2BRobots/skykontrolVending/README.md

# skykontrolVending
This repository contains all the hardware and software used by 2BRobots to create and support IoT vending machines.
