2BRobots/skykontrolVending/Cloud/skykontrol/images/2brobots.png

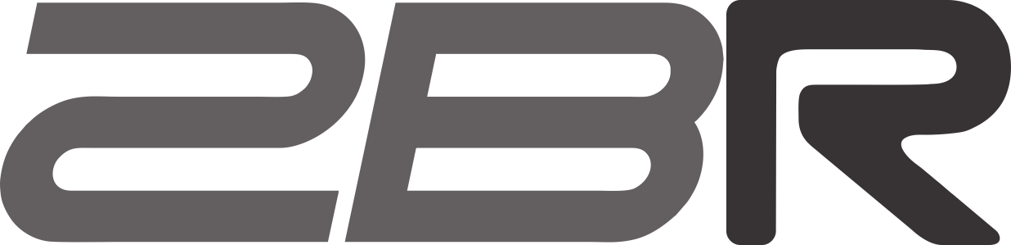
Cloud/skykontrol/images/2brobots.png
