2BRobots/skykontrolVending/Cloud/skykontrol/images/ecofill.png

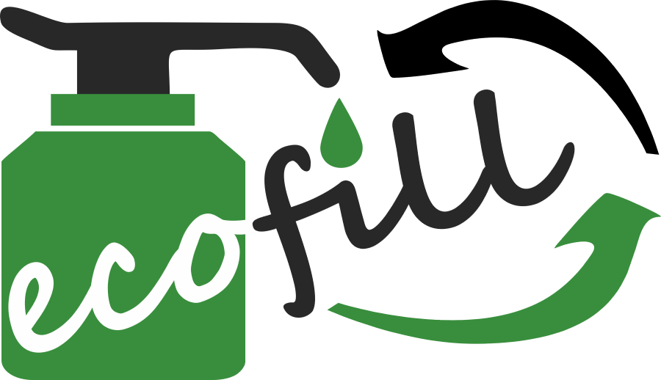
Cloud/skykontrol/images/ecofill.png
