2BRobots/skykontrolVending/Hardware/BasicDisplay/bottom.png

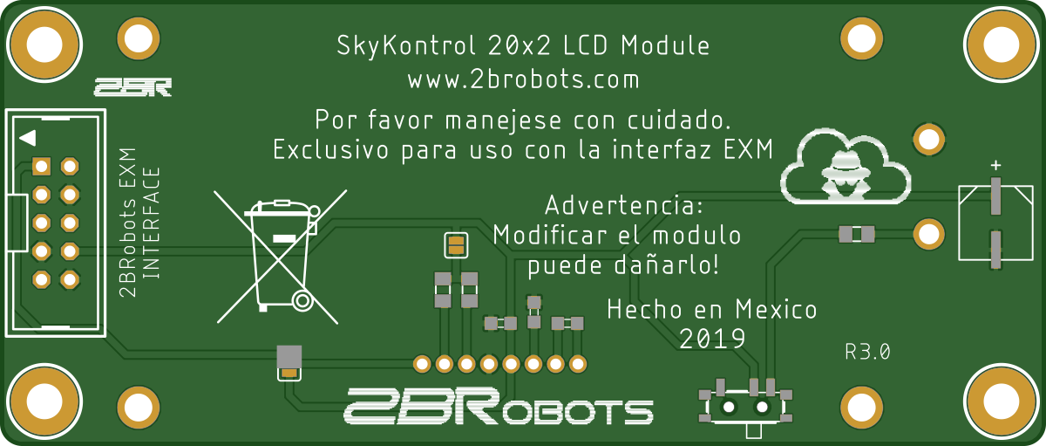
Hardware/BasicDisplay/bottom.png
