2BRobots/skykontrolVending/Hardware/BasicDisplay/schematic.png

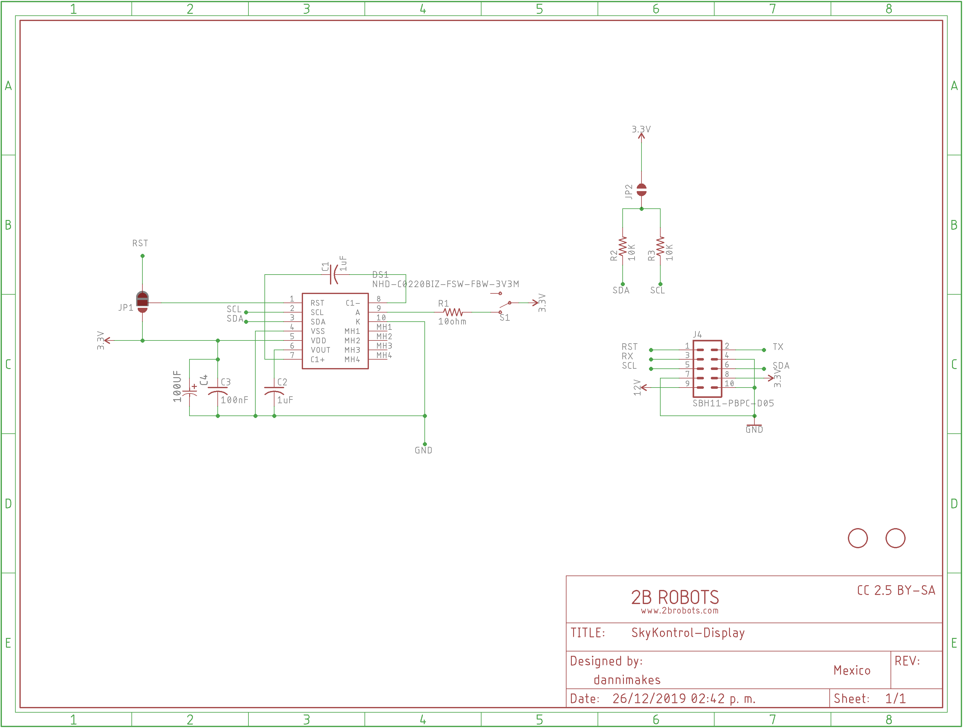
Hardware/BasicDisplay/schematic.png
