2BRobots/skykontrolVending/Hardware/BasicDisplay/top.png

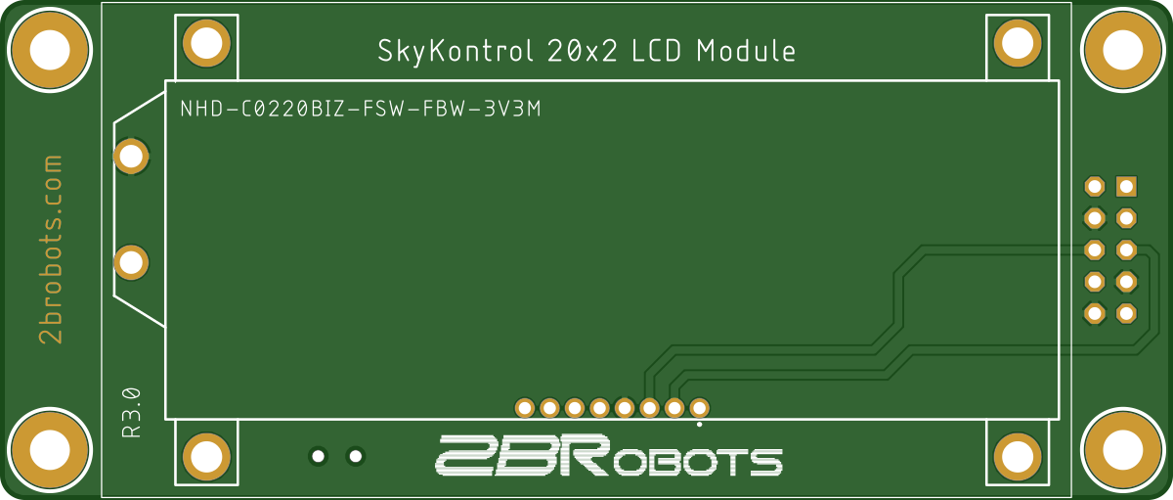
Hardware/BasicDisplay/top.png
