2BRobots/skykontrolVending/Hardware/Datalogger/bottom.png

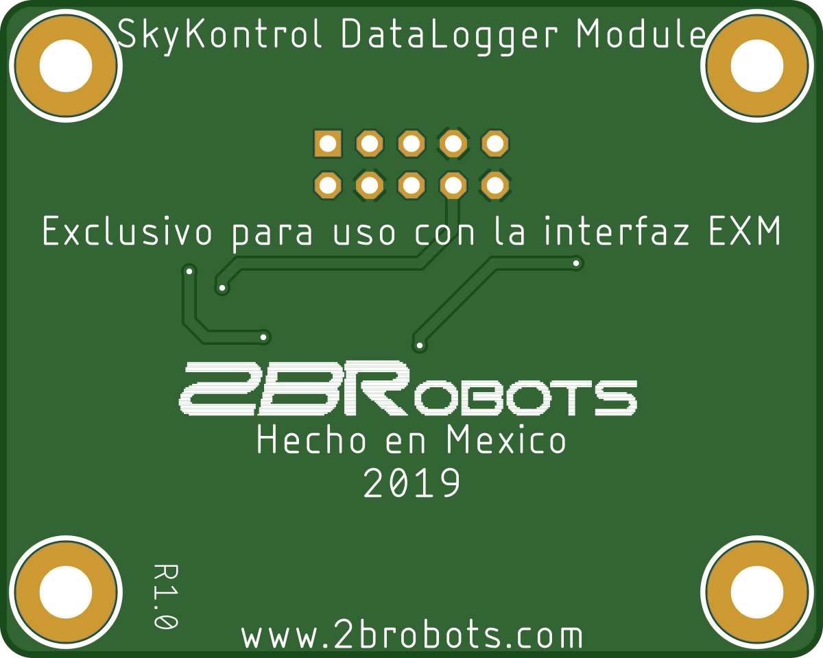
Hardware/Datalogger/bottom.png
