2BRobots/skykontrolVending/Hardware/Datalogger/schematic.png

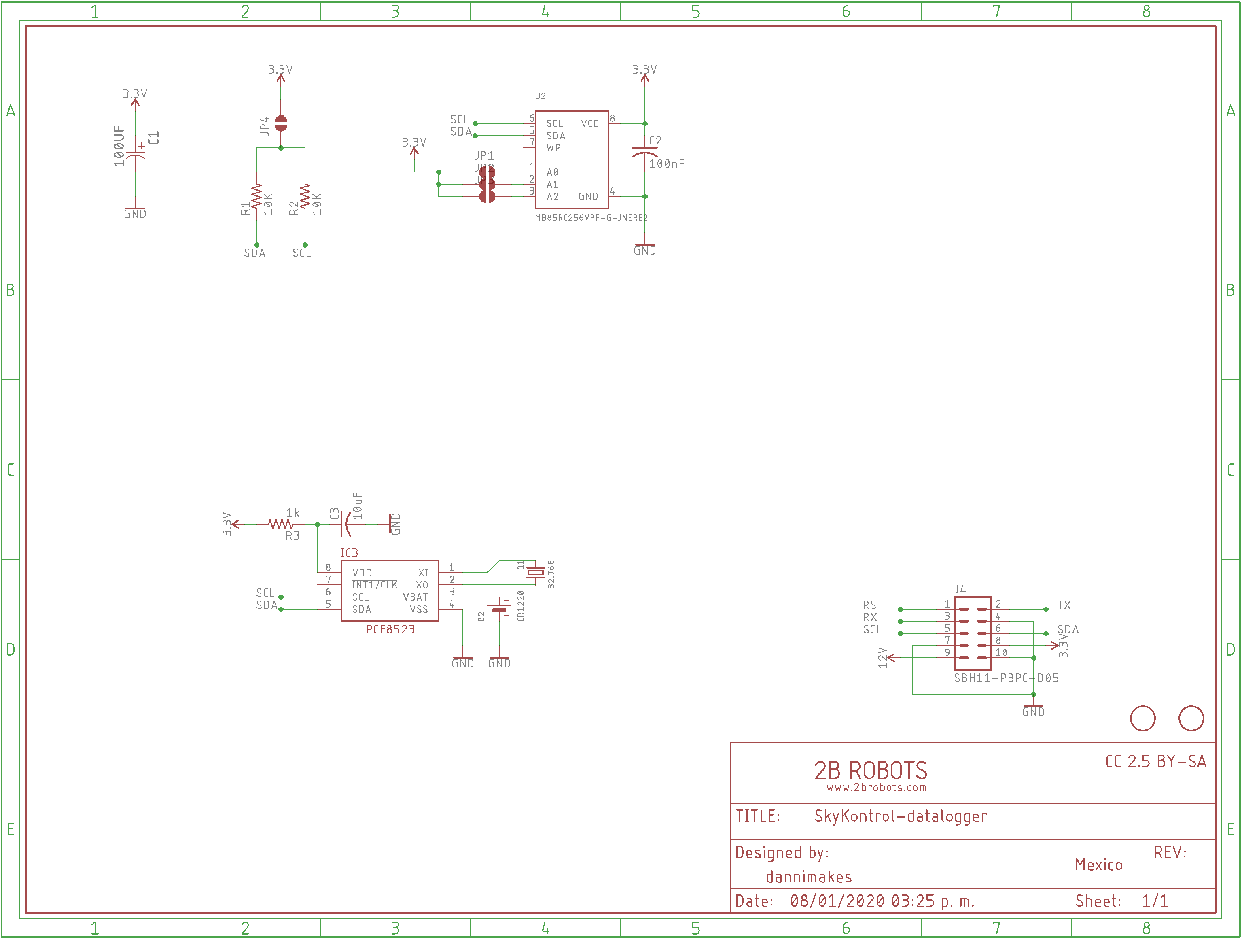
Hardware/Datalogger/schematic.png
