2BRobots/skykontrolVending/Hardware/Datalogger/top.png

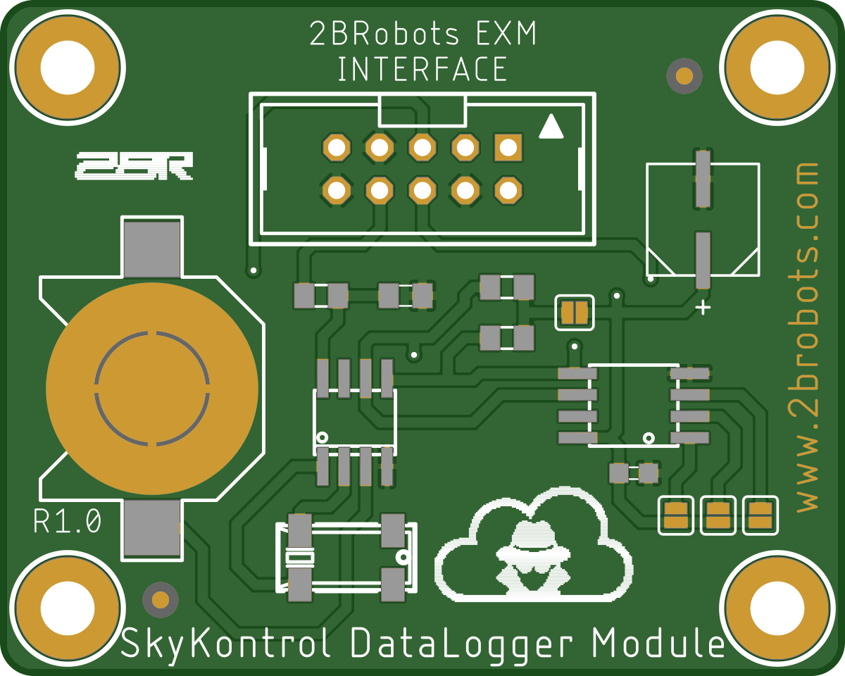
Hardware/Datalogger/top.png
