2BRobots/skykontrolVending/Hardware/IotController/bottom.png

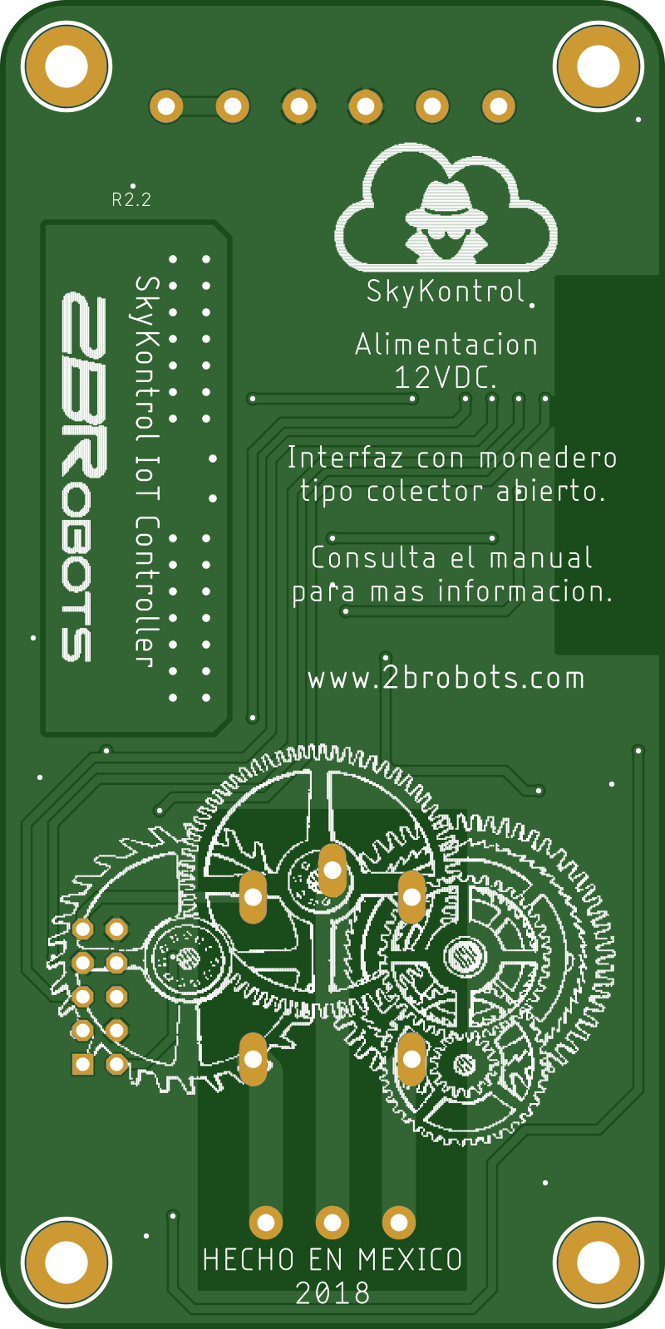
Hardware/IotController/bottom.png
