2BRobots/skykontrolVending/Hardware/IotController/firmware/skykontrol_IoT_controller/data/skykontrol.png

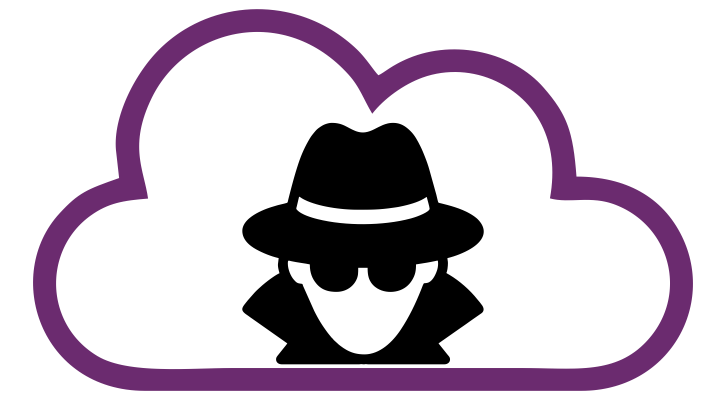
Hardware/IotController/firmware/skykontrol_IoT_controller/data/skykontrol.png
