2BRobots/skykontrolVending/Hardware/IotController/schematic.png

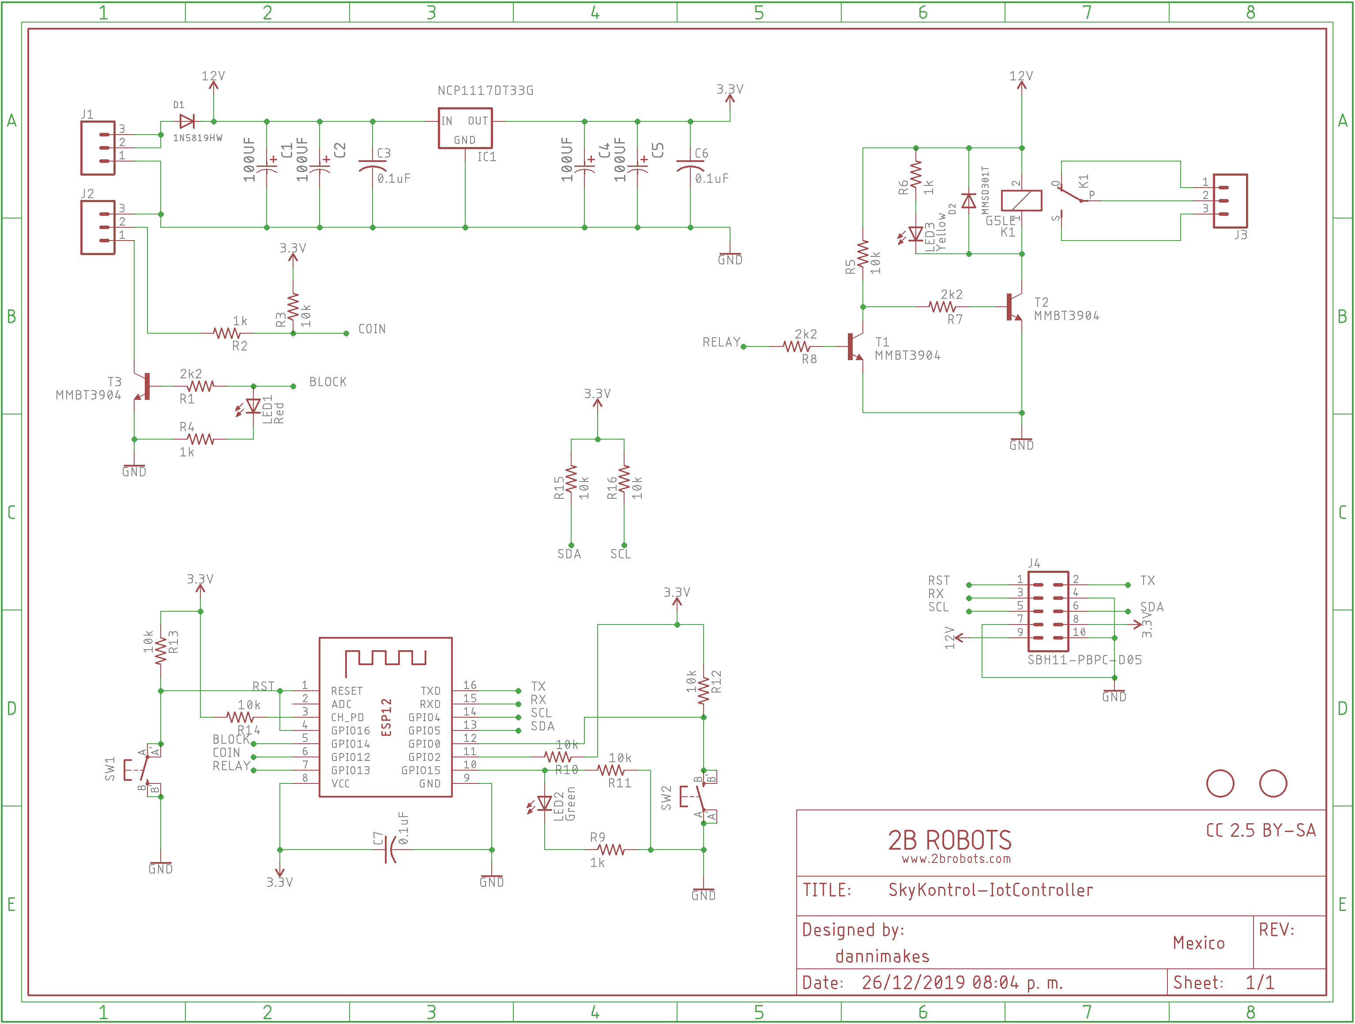
Hardware/IotController/schematic.png
