2BRobots/skykontrolVending/Hardware/IotController/top.png

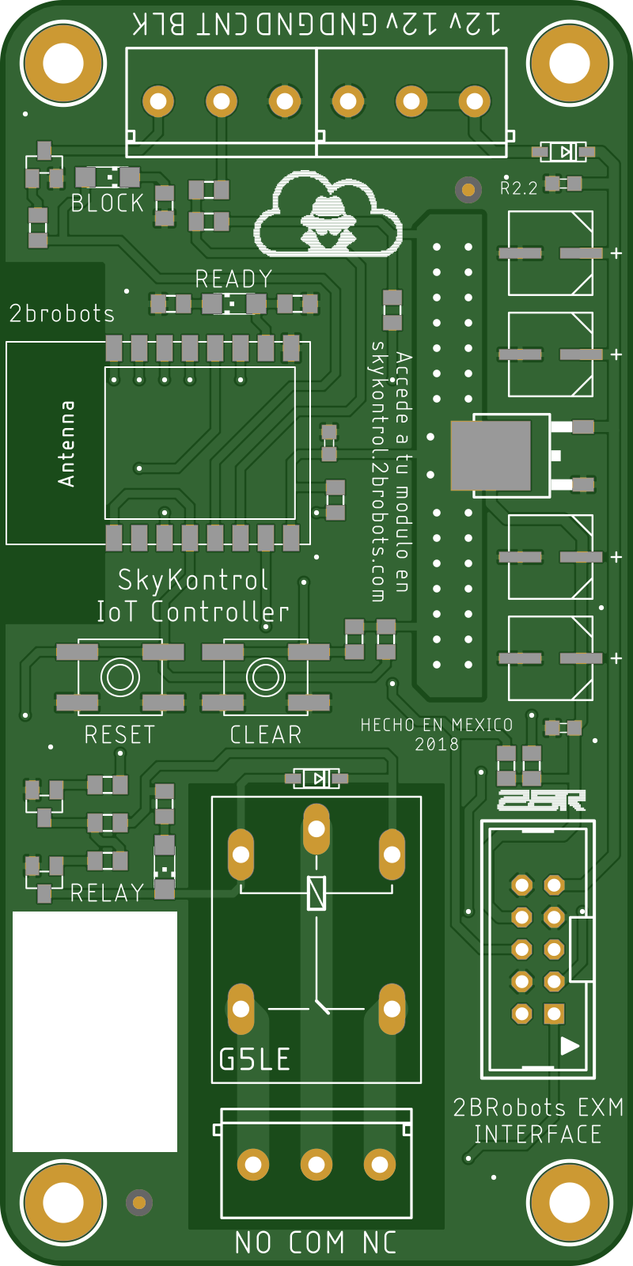
Hardware/IotController/top.png
