2BRobots/skykontrolVending/Hardware/LevelSensor/bottom.png

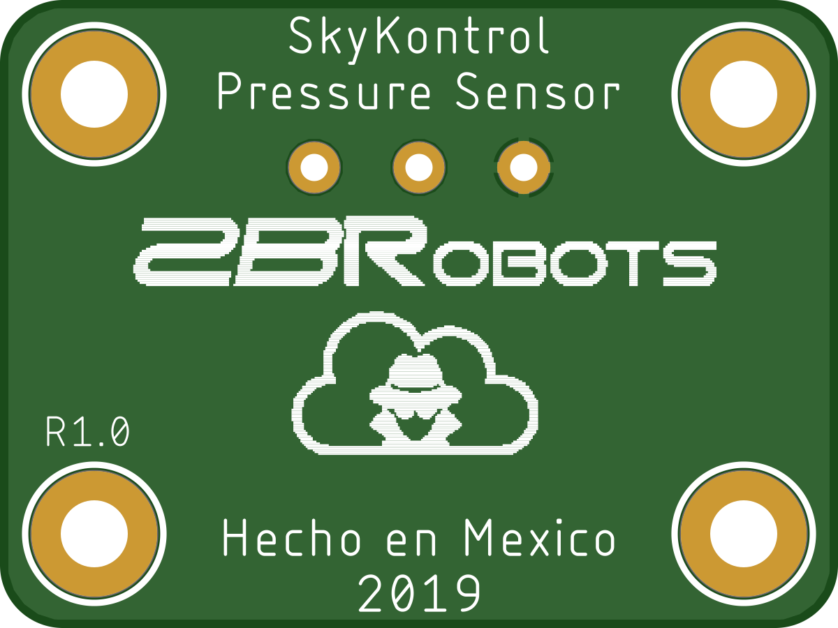
Hardware/LevelSensor/bottom.png
