2BRobots/skykontrolVending/Hardware/LevelSensor/schematic.png

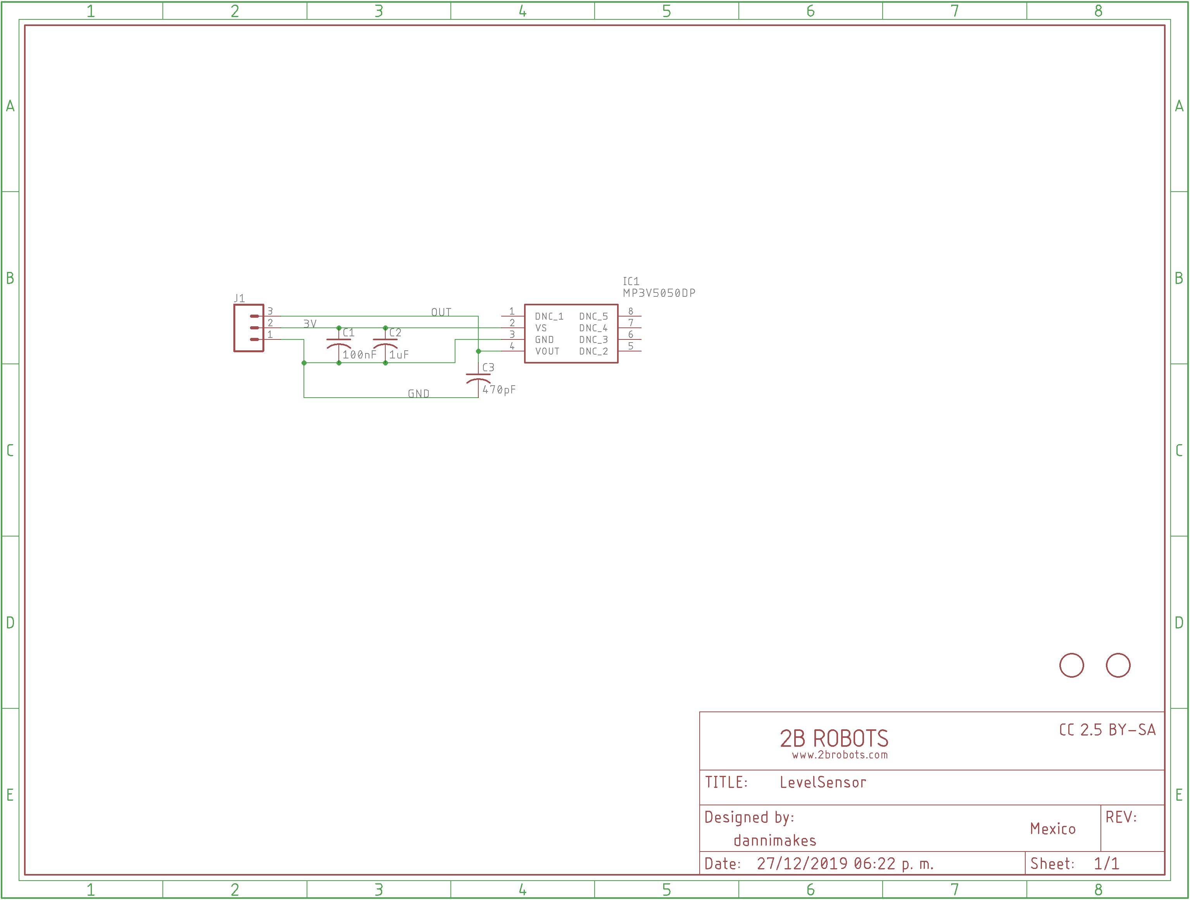
Hardware/LevelSensor/schematic.png
