2BRobots/skykontrolVending/Hardware/LevelSensor/top.png

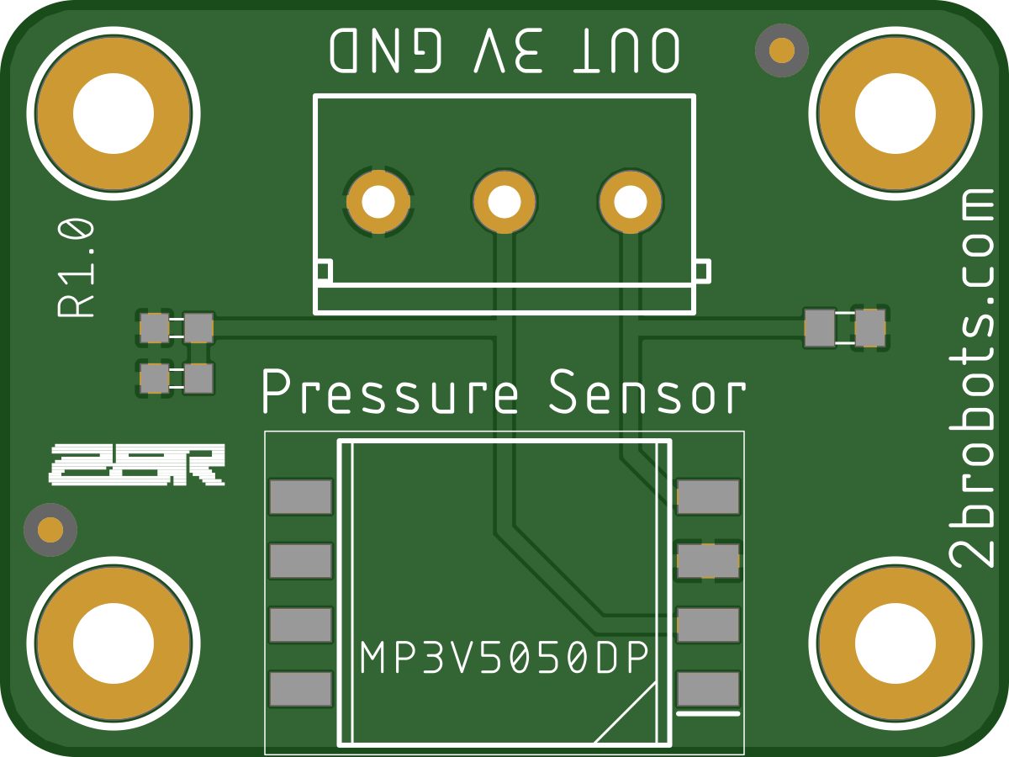
Hardware/LevelSensor/top.png
