2BRobots/skykontrolVending/Hardware/PowerMeter/bottom.png

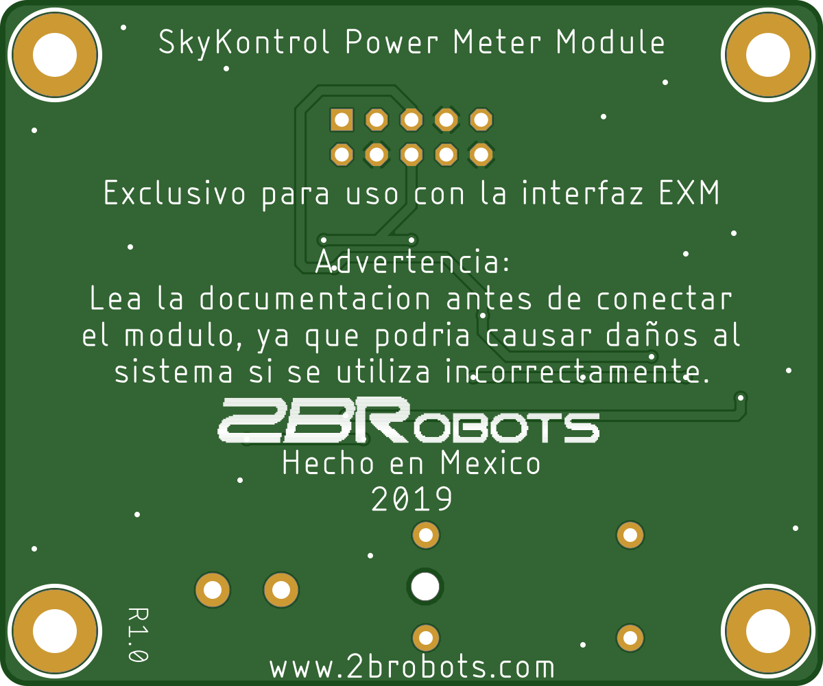
Hardware/PowerMeter/bottom.png
