2BRobots/skykontrolVending/Hardware/PowerMeter/schematic.png

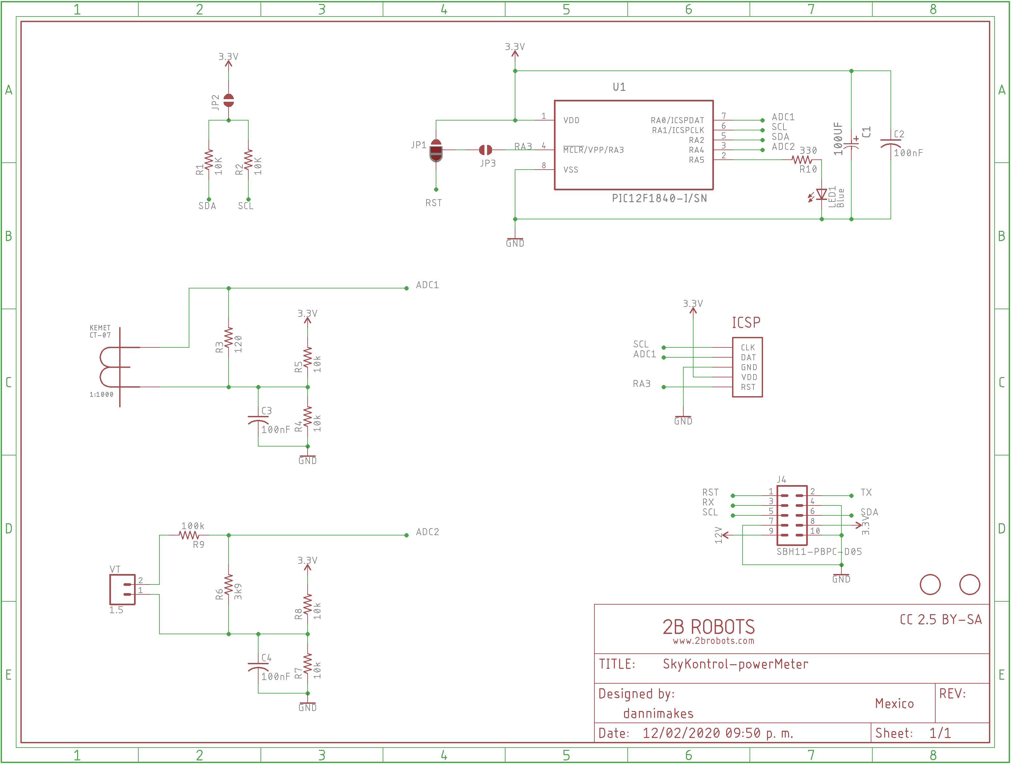
Hardware/PowerMeter/schematic.png
