2BRobots/skykontrolVending/Hardware/PowerMeter/top.png

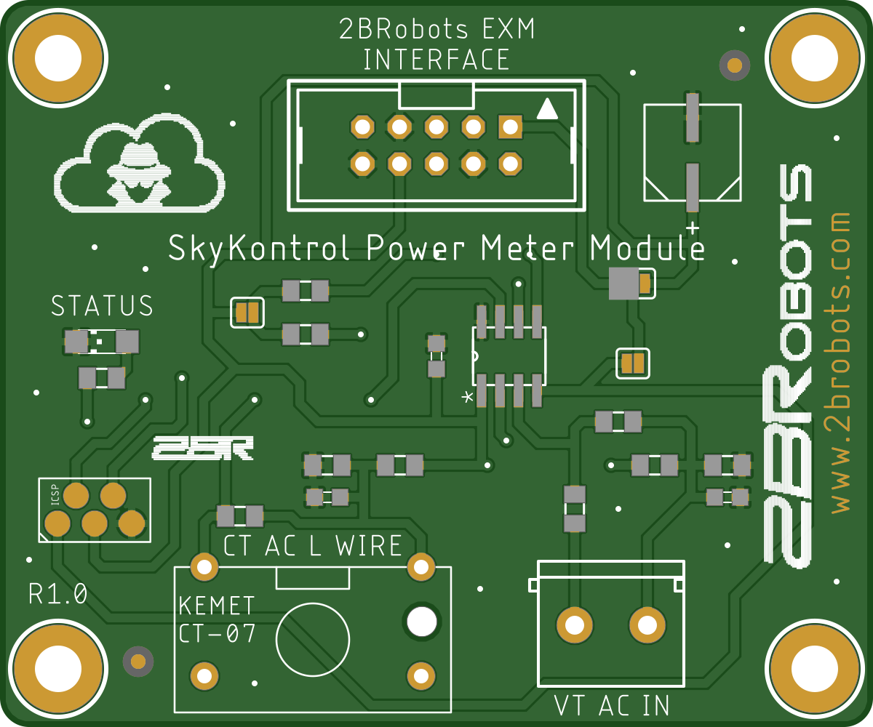
Hardware/PowerMeter/top.png
