2BRobots/skykontrolVending/Hardware/SlotExpansion/bottom.png

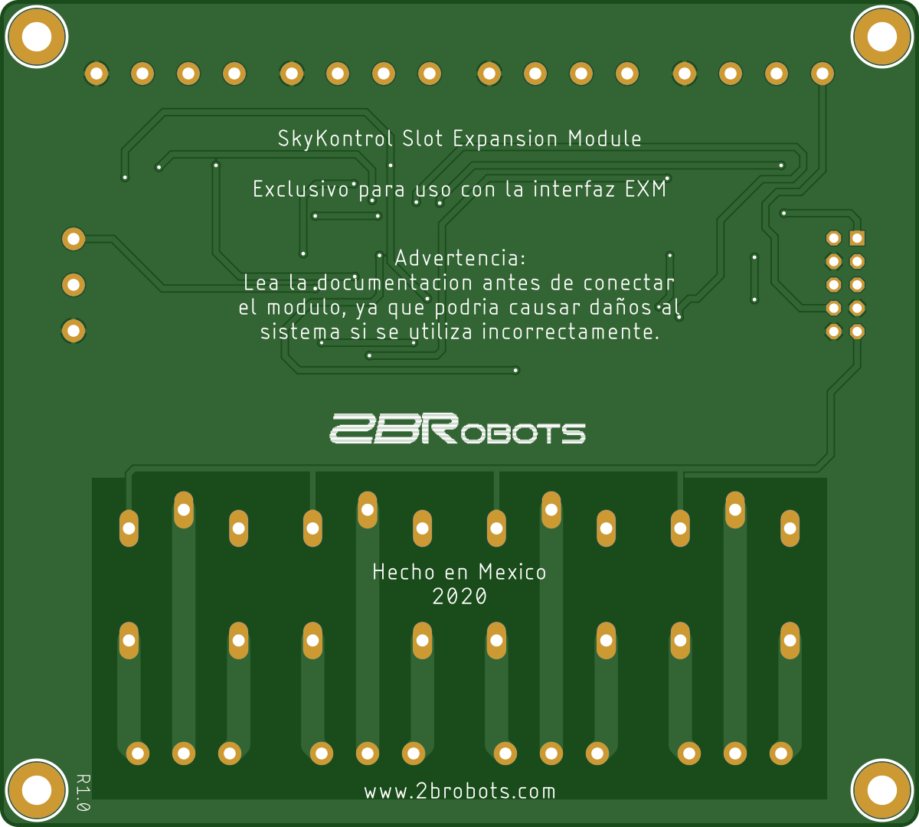
Hardware/SlotExpansion/bottom.png
