2BRobots/skykontrolVending/Hardware/SlotExpansion/schematic.png

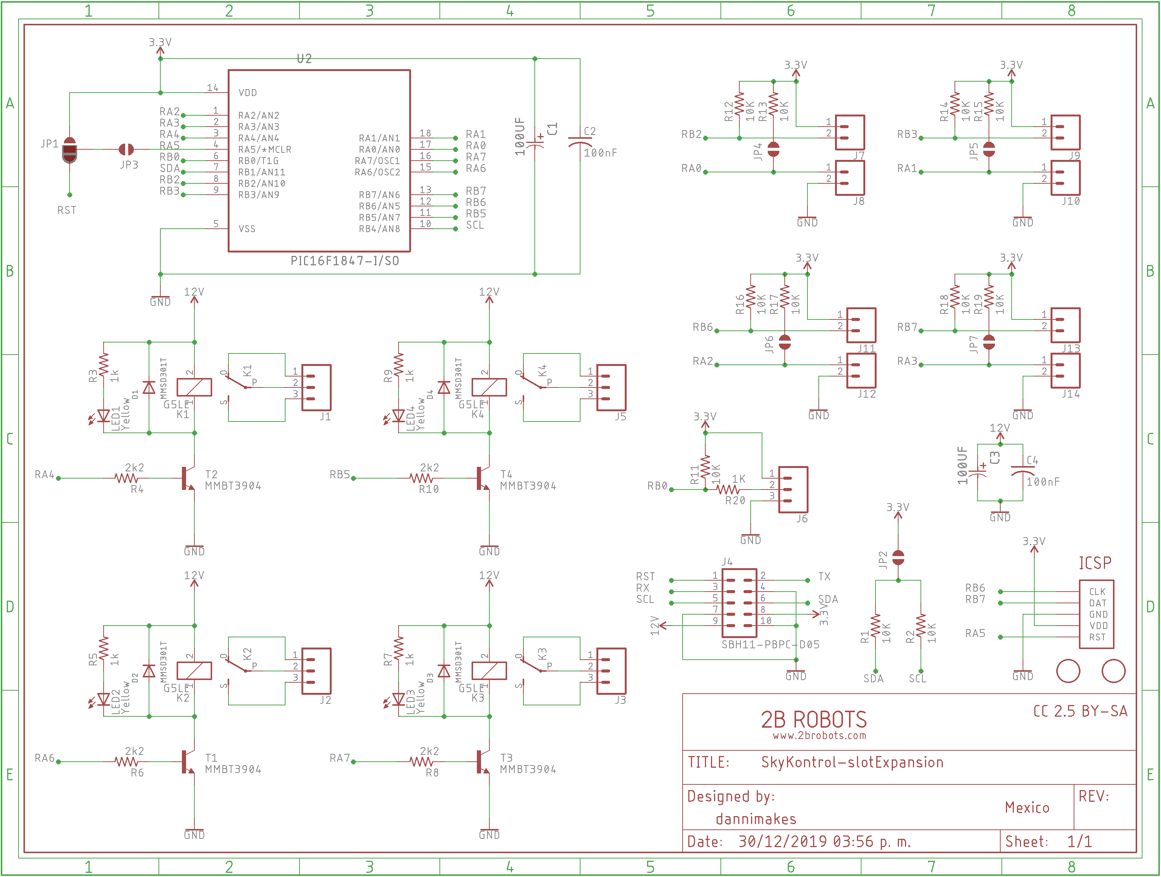
Hardware/SlotExpansion/schematic.png
