2BRobots/skykontrolVending/Hardware/SlotExpansion/top.png

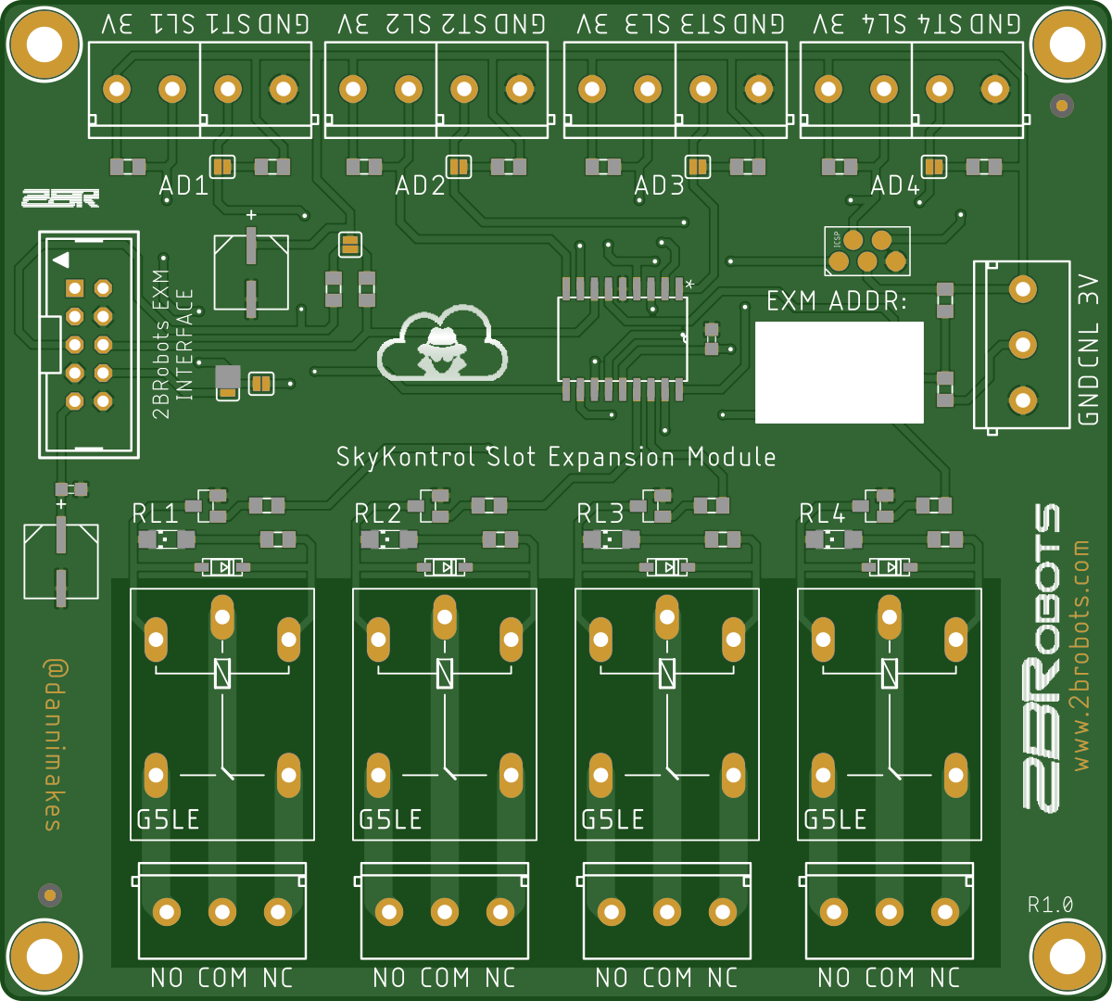
Hardware/SlotExpansion/top.png
