2BRobots/skykontrolVending/Hardware/SmartDisplay/bottom.png

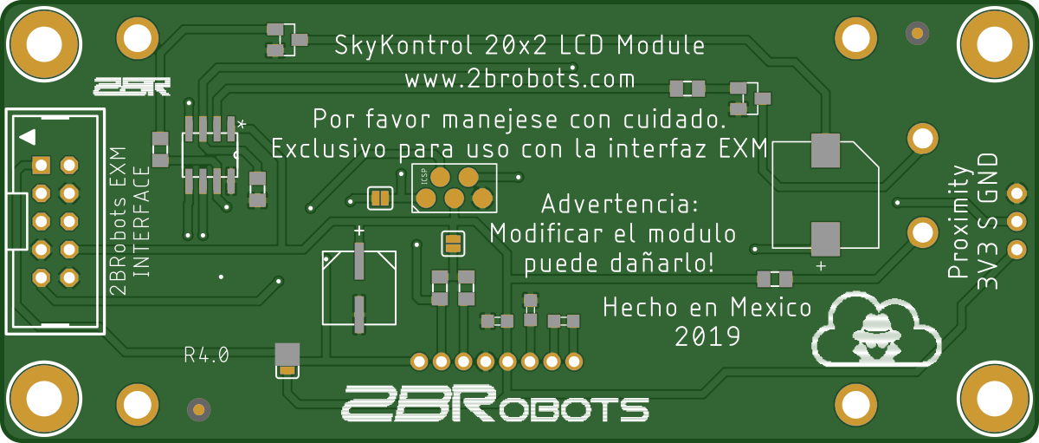
Hardware/SmartDisplay/bottom.png
