2BRobots/skykontrolVending/Hardware/SmartDisplay/schematic.png

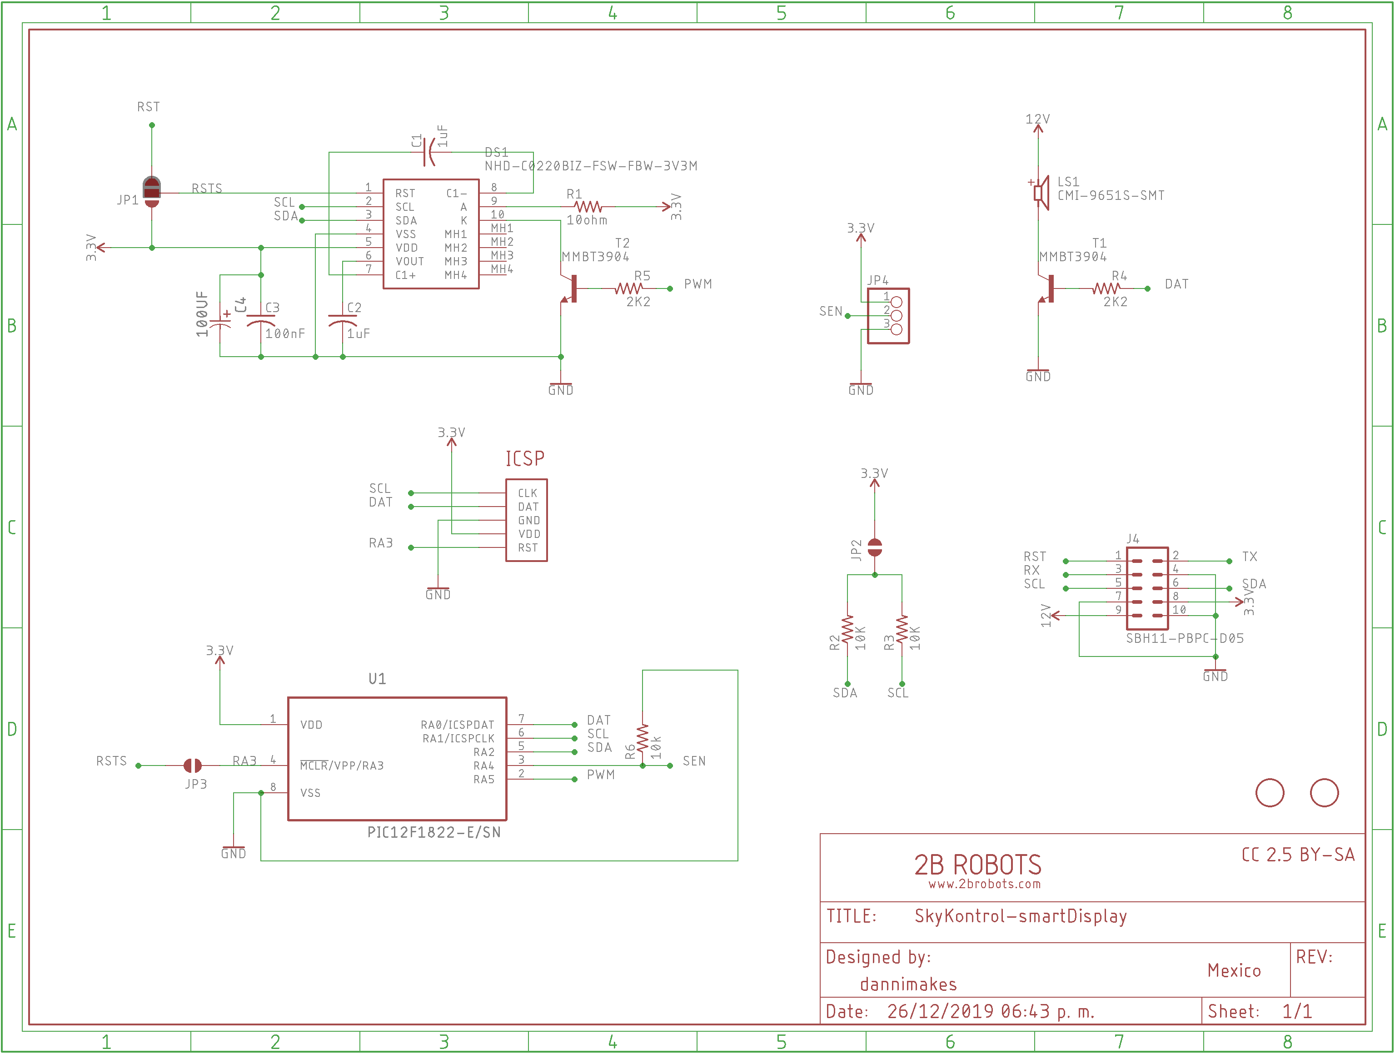
Hardware/SmartDisplay/schematic.png
