2BRobots/skykontrolVending/Hardware/SmartDisplay/top.png

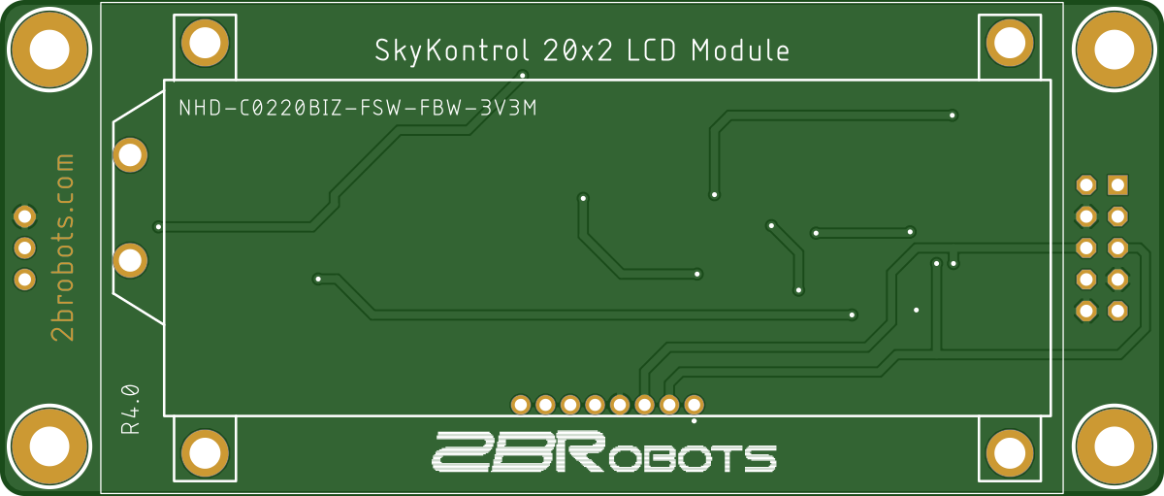
Hardware/SmartDisplay/top.png
