2BRobots/skykontrolVending/Hardware/USB Terminal/botton.png

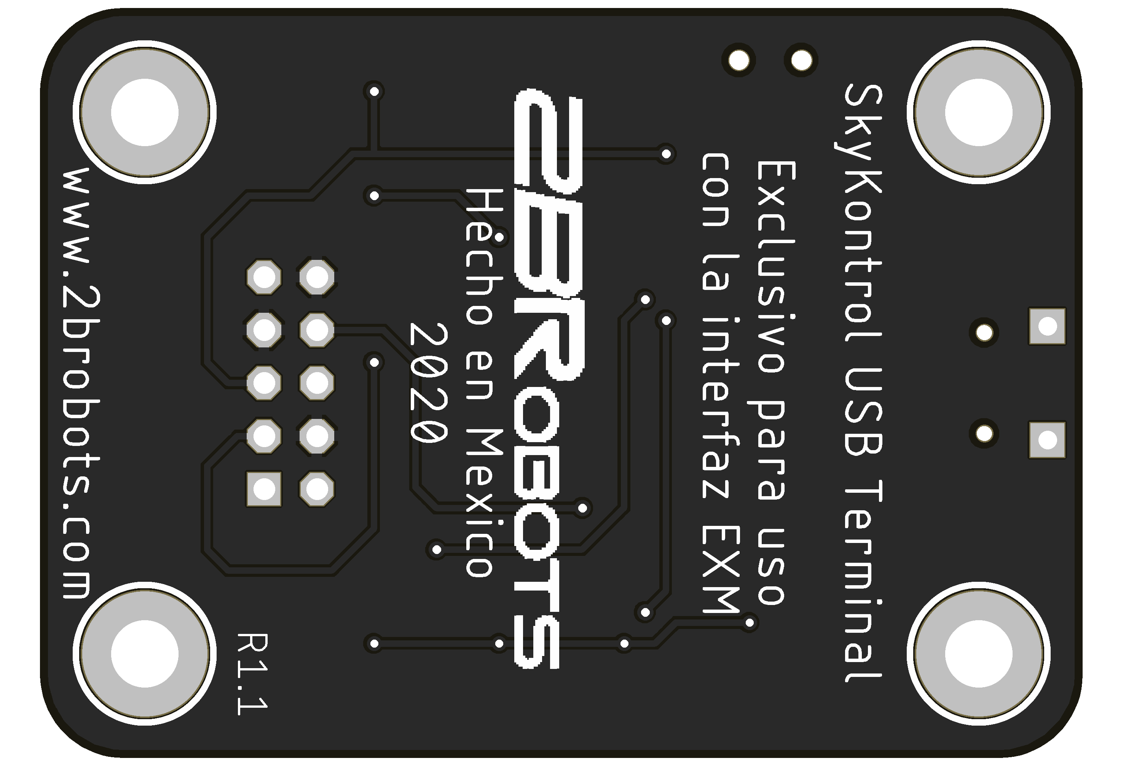
Hardware/USB Terminal/botton.png
