2BRobots/skykontrolVending/Hardware/USB Terminal/schematic.png

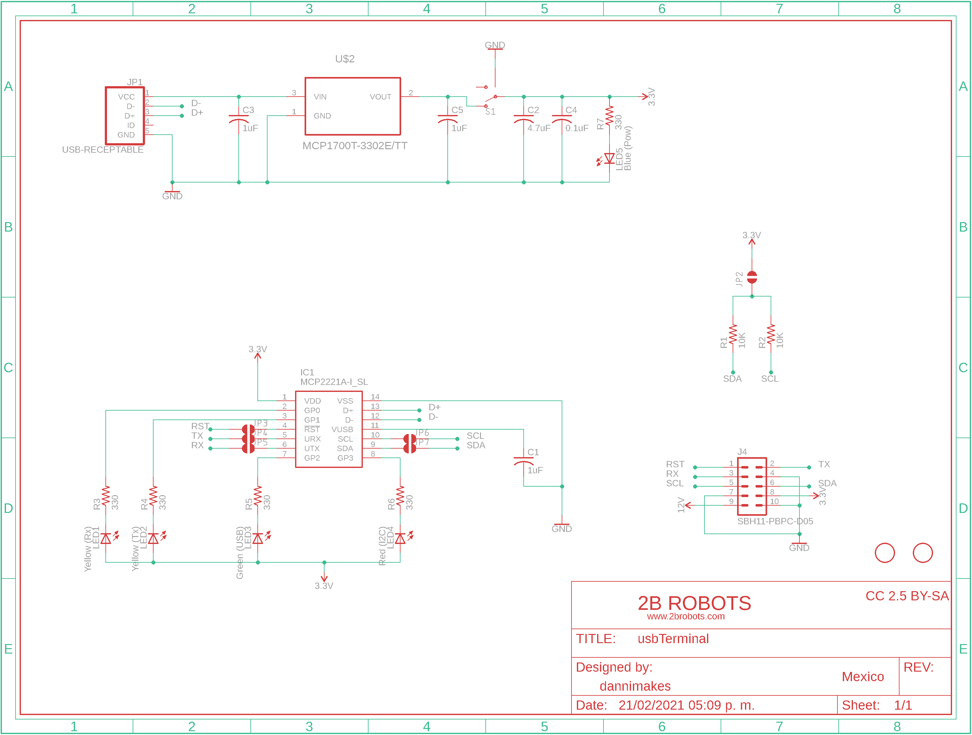
Hardware/USB Terminal/schematic.png
