2BRobots/skykontrolVending/Hardware/USB Terminal/top.png

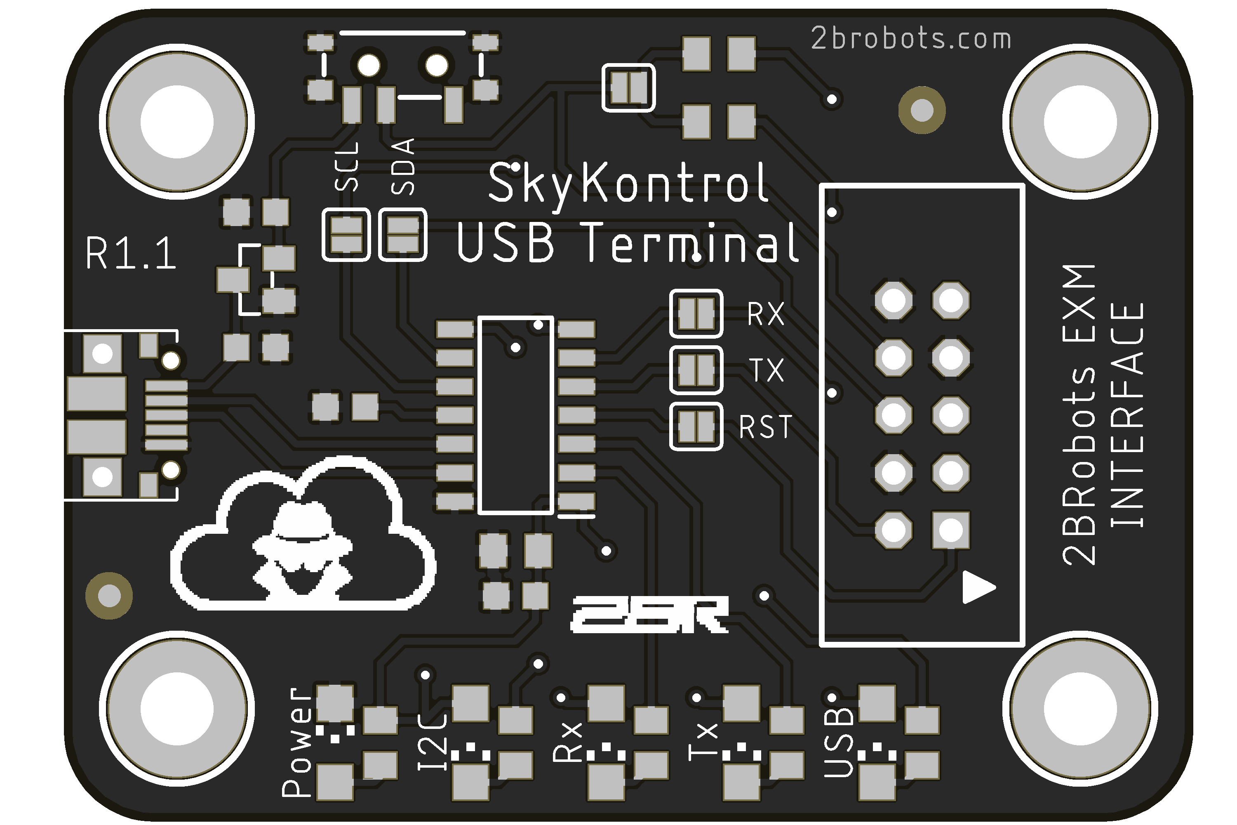
Hardware/USB Terminal/top.png
