2BRobots/skykontrolVending/Hardware/WatchDog/botton.png

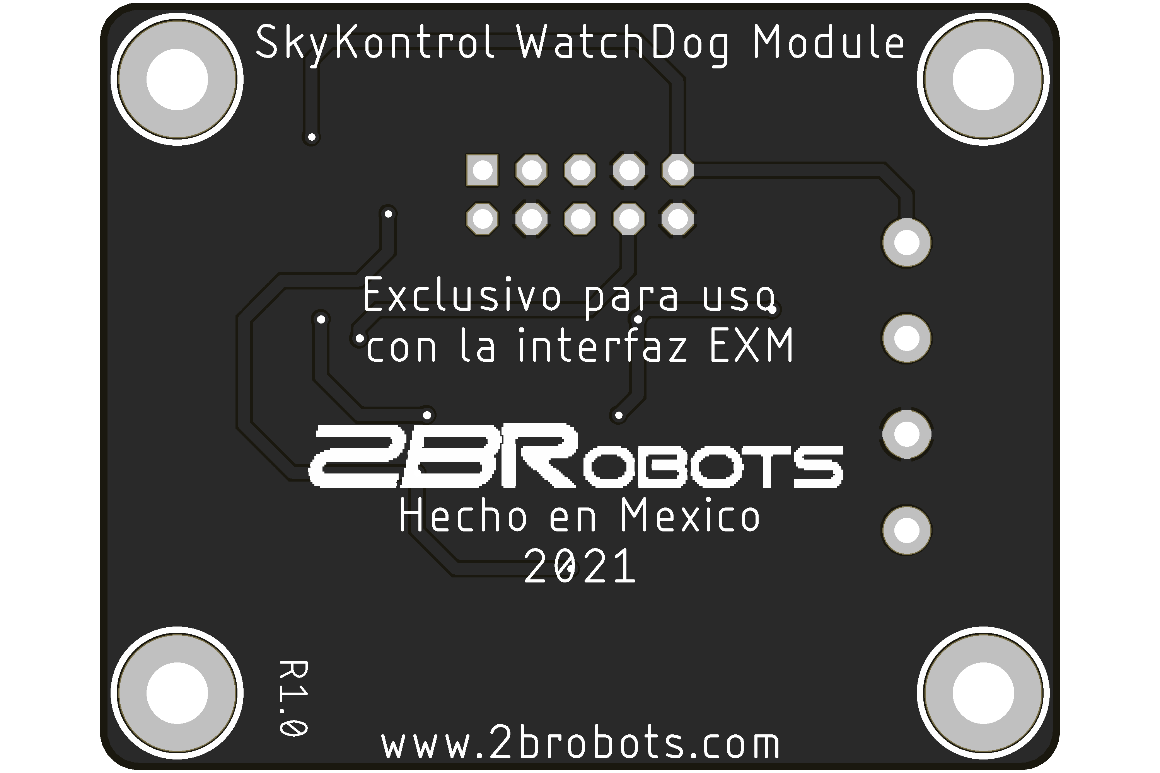
Hardware/WatchDog/botton.png
