2BRobots/skykontrolVending/Hardware/WatchDog/schematic.png

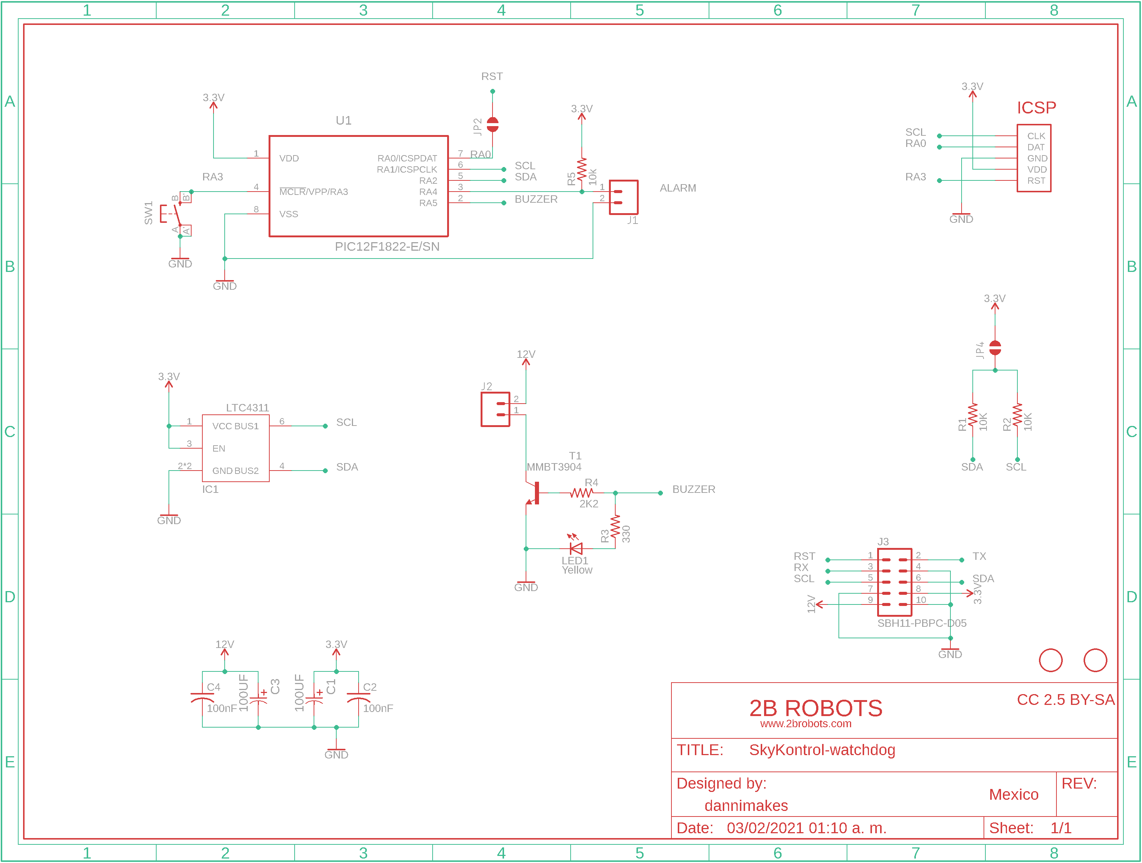
Hardware/WatchDog/schematic.png
