2BRobots/skykontrolVending/Hardware/WatchDog/top.png

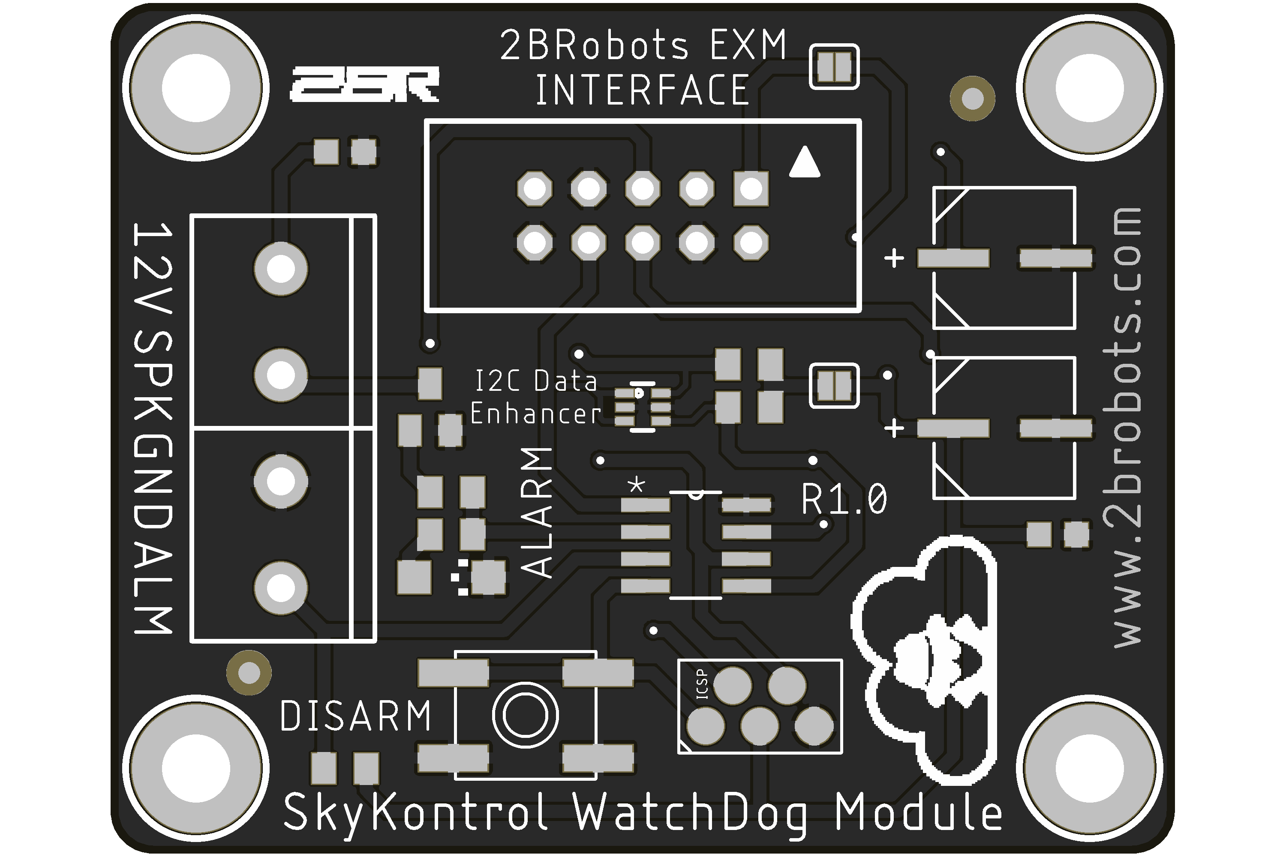
Hardware/WatchDog/top.png
