2BRobots/skykontrolVending/Hardware/WatchDog/BOM.txt

Part Value                Device                    Package              Description                                                                                                     MPN             OC_FARNELL OC_NEWARK PACKAGE PIC POGO POPULARITY PROGRAMING SF_SKU    SMT SUPPLIER  TOLERANCE VALUE VOLTAGERATING
C1   100UF                EEE-HA1E101XP-CASE-D8     CAPAE660X800N        Aluminum Electrolytic Capacitors,Surface Mount Type                                                             EEE-HA1E101XP   1973328    58T9236   CASE-D8                                              PANASONIC ±20 %     100UF 25V          
C2   100nF                C-USC0603K                C0603K               CAPACITOR, American symbol                                                                                                                                                                                                                       
C3   100UF                EEE-HA1E101XP-CASE-D8     CAPAE660X800N        Aluminum Electrolytic Capacitors,Surface Mount Type                                                             EEE-HA1E101XP   1973328    58T9236   CASE-D8                                              PANASONIC ±20 %     100UF 25V          
C4   100nF                C-USC0603K                C0603K               CAPACITOR, American symbol                                                                                                                                                                                                                       
IC1  LTC4311_SC70         LTC4311_SC70              SC70-6L                                                                                                                                                                                                                                                               
J1                        CONN_025MM                SCREWTERMINAL-5MM-2  Multi connection point. Often used as Generic Header-pin footprint for 0.1 inch spaced/style header connections                                                                             PRT-08432                                            
J2                        CONN_025MM                SCREWTERMINAL-5MM-2  Multi connection point. Often used as Generic Header-pin footprint for 0.1 inch spaced/style header connections                                                                             PRT-08432                                            
J3   SBH11-PBPC-D05       SBH11-PBPC-D05            SBH11-PBPC-D05       HEADER - Vertical, Shrouded                                                                                                                                                                                                                      
JP2  JUMPER-SMT_2_NO_SILK JUMPER-SMT_2_NO_SILK      SMT-JUMPER_2_NO_SILK Normally open jumper                                                                                                                                                                                                                             
JP4  JUMPER-SMT_2_NO_SILK JUMPER-SMT_2_NO_SILK      SMT-JUMPER_2_NO_SILK Normally open jumper                                                                                                                                                                                                                             
LED1 Yellow               LEDCHIPLED_1206           CHIPLED_1206         LED                                                                                                                                                                                                                                              
R1   10K                  R-US_R0805                R0805                RESISTOR, American symbol                                                                                                                                                                                                                        
R2   10K                  R-US_R0805                R0805                RESISTOR, American symbol                                                                                                                                                                                                                        
R3   330                  R-US_R0805                R0805                RESISTOR, American symbol                                                                                                                                                                                                                        
R4   2K2                  R-US_R0805                R0805                RESISTOR, American symbol                                                                                                                                                                                                                        
R5   10k                  R-US_R0805                R0805                RESISTOR, American symbol                                                                                                                                                                                                                        
SW1  SPST_TACT-EVQQ2      SPST_TACT-EVQQ2           EVQ-Q2               SMT 6mm switch, EVQQ2 series                                                                                                                                                                                                                     
T1   MMBT3904             MMBT3904LT1-NPN-SOT23-BEC SOT23-BEC            NPN Transistror                                                                                                                                                       0                                                                          
U$1  FIDUCIAL             FIDUCIAL                  FIDUCIAL_1MM         For use by pick and place machines to calibrate the vision/machine, 1mm                                                                                                                                                                          
U$2  ICSP_POGO            ICSP_POGO                 ICSP_POGO                                                                                                                                                                                                                                                             
U$3  FIDUCIAL             FIDUCIAL                  FIDUCIAL_1MM         For use by pick and place machines to calibrate the vision/machine, 1mm                                                                                                                                                                          
U1   PIC12F1822-E/SN      PIC12F1822-E/SN           SOIC127P600X175-8N   8/14-Pin Flash Microcontrollers,SOIC-8                                                                          PIC12F1822-E/SN 2315760    53R0195   SOIC-8                                               Microchip
