2BRobots/skykontrolVending/Hardware/USB Terminal/BOM.txt

Part Value                Device                      Package              Description                                                             DESCRIPTION                                         HEIGHT MANUFACTURER_NAME MANUFACTURER_PART_NUMBER MOUSER_PART_NUMBER MOUSER_PRICE-STOCK                                                    MPN               OC_FARNELL OC_NEWARK PACKAGE PROD_ID    SF_SKU    SUPPLIER 
C1   1uF                  C-USC0603K                  C0603K               CAPACITOR, American symbol                                                                                                                                                                                                                                                                                                                          
C2   4.7uF                C-USC0805K                  C0805K               CAPACITOR, American symbol                                                                                                                                                                                                                                                                                                                          
C3   1uF                  C-USC0603K                  C0603K               CAPACITOR, American symbol                                                                                                                                                                                                                                                                                                                          
C4   0.1uF                C-USC0603K                  C0603K               CAPACITOR, American symbol                                                                                                                                                                                                                                                                                                                          
C5   1uF                  C-USC0603K                  C0603K               CAPACITOR, American symbol                                                                                                                                                                                                                                                                                                                          
IC1  MCP2221A-I_SL        MCP2221A-I_SL               SOIC127P600X175-14N  USB Interface IC USB 2.0 to I2C Converter with GPIO                     USB Interface IC USB 2.0 to I2C Converter with GPIO 1.75mm Microchip         MCP2221A-I/SL            579-MCP2221A-I/SL  https://www.mouser.com/Search/Refine.aspx?Keyword=579-MCP2221A-I%2FSL                                                                              
J4   SBH11-PBPC-D05       SBH11-PBPC-D05              SBH11-PBPC-D05       HEADER - Vertical, Shrouded                                                                                                                                                                                                                                                                                                                         
JP1  USB-RECEPTABLE       USB-RECEPTABLE              FCI-10103594-0001LF  USB Receptable                                                                                                                                                                                                                                                                                                                                      
JP2  JUMPER-SMT_2_NO_SILK JUMPER-SMT_2_NO_SILK        SMT-JUMPER_2_NO_SILK Normally open jumper                                                                                                                                                                                                                                                                                                                                
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
U$1  FIDUCIAL             FIDUCIAL                    FIDUCIAL_1MM         For use by pick and place machines to calibrate the vision/machine, 1mm                                                                                                                                                                                                                                                                             
U$2  MCP1700T-3302E/TT    MCP1700T-3302E/TT           SOT95P237X112-3N     Low Quiescent Current LDO                                                                                                                                                                                                                                              MCP1700T-3302E/TT 1296592    88H9817   SOT23-3                      Microchip
U$3  FIDUCIAL             FIDUCIAL                    FIDUCIAL_1MM         For use by pick and place machines to calibrate the vision/machine, 1mm
