2BRobots/skykontrolVending/Hardware/BasicDisplay/BOM.txt

Part Value                        Device                       Package                      Description                                                                  DESCRIPTION                                                                  HEIGHT MANUFACTURER_NAME MANUFACTURER_PART_NUMBER  MOUSER_PART_NUMBER   MOUSER_PRICE-STOCK                                                     MPN           OC_FARNELL OC_NEWARK PACKAGE PROD_ID    SF_SKU    SUPPLIER  TOLERANCE VALUE VOLTAGERATING
C1   1uF                          C-USC0603K                   C0603K                       CAPACITOR, American symbol                                                                                                                                                                                                                                                                                                                                                                                      
C2   1uF                          C-USC0603K                   C0603K                       CAPACITOR, American symbol                                                                                                                                                                                                                                                                                                                                                                                      
C3   100nF                        C-USC0603K                   C0603K                       CAPACITOR, American symbol                                                                                                                                                                                                                                                                                                                                                                                      
C4   100UF                        EEE-HA1E101XP-CASE-D8        CAPAE660X800N                Aluminum Electrolytic Capacitors,Surface Mount Type                                                                                                                                                                                                                                                      EEE-HA1E101XP 1973328    58T9236   CASE-D8                      PANASONIC ±20 %     100UF 25V          
DS1  NHD-C0220BIZ-FSW-FBW-3V3M    NHD-C0220BIZ-FSW-FBW-3V3M    NHDC0220BIZFSWFBW3V3M        LCD Character Display Modules & Accessories 2 x 20 FSTN (+) Transf White LED LCD Character Display Modules & Accessories 2 x 20 FSTN (+) Transf White LED 7mm    Newhaven Display  NHD-C0220BIZ-FSW-FBW-3V3M 763-C0220BIZ-FSW-FBW https://www.mouser.com/Search/Refine.aspx?Keyword=763-C0220BIZ-FSW-FBW                                                                                                        
J4   SBH11-PBPC-D05               SBH11-PBPC-D05               SBH11-PBPC-D05               HEADER - Vertical, Shrouded                                                                                                                                                                                                                                                                                                                                                                                     
JP1  JUMPER-SMT_3_1-NC_PASTE_SILK JUMPER-SMT_3_1-NC_PASTE_SILK SMT-JUMPER_3_1-NC_PASTE_SILK Normally closed solder jumper (1 of 2 connections)                                                                                                                                                                                                                                                                                                                                                              
JP2  JUMPER-SMT_2_NO_SILK         JUMPER-SMT_2_NO_SILK         SMT-JUMPER_2_NO_SILK         Normally open jumper                                                                                                                                                                                                                                                                                                                                                                                            
R1   10ohm                        R-US_R0805                   R0805                        RESISTOR, American symbol                                                                                                                                                                                                                                                                                                                                                                                       
R2   10K                          R-US_R0805                   R0805                        RESISTOR, American symbol                                                                                                                                                                                                                                                                                                                                                                                       
R3   10K                          R-US_R0805                   R0805                        RESISTOR, American symbol                                                                                                                                                                                                                                                                                                                                                                                       
S1                                SWITCH-SPDT-SMD-RIGHT-ANGLE  SWITCH_SPST_SMD_A            Single Pole, Double Throw (SPDT) Switch                                                                                                                                                                                                                                                                                                             SWCH-10651 COM-10860
