2BRobots/skykontrolVending/Hardware/Datalogger/BOM.txt

Part Value                 Device                Package              Description                                                             MPN           OC_FARNELL OC_NEWARK PACKAGE SUPPLIER  TOLERANCE VALUE VOLTAGERATING
B2   CR1220                BATTERYCR1220_SMT     CR1220               CR1220 SMT - Digikey: 3001K-ND                                                                                                                            
C1   100UF                 EEE-HA1E101XP-CASE-D8 CAPAE660X800N        Aluminum Electrolytic Capacitors,Surface Mount Type                     EEE-HA1E101XP 1973328    58T9236   CASE-D8 PANASONIC ±20 %     100UF 25V          
C2   100nF                 C-USC0603K            C0603K               CAPACITOR, American symbol                                                                                                                                
C3   10uF                  C-USC0805K            C0805K               CAPACITOR, American symbol                                                                                                                                
IC3  RTC_PCF8523T          RTC_PCF8523T          SOIC8_150MIL                                                                                                                                                                   
J4   SBH11-PBPC-D05        SBH11-PBPC-D05        SBH11-PBPC-D05       HEADER - Vertical, Shrouded                                                                                                                               
JP1  JUMPER-SMT_2_NO_SILK  JUMPER-SMT_2_NO_SILK  SMT-JUMPER_2_NO_SILK Normally open jumper                                                                                                                                      
JP2  JUMPER-SMT_2_NO_SILK  JUMPER-SMT_2_NO_SILK  SMT-JUMPER_2_NO_SILK Normally open jumper                                                                                                                                      
JP3  JUMPER-SMT_2_NO_SILK  JUMPER-SMT_2_NO_SILK  SMT-JUMPER_2_NO_SILK Normally open jumper                                                                                                                                      
JP4  JUMPER-SMT_2_NO_SILK  JUMPER-SMT_2_NO_SILK  SMT-JUMPER_2_NO_SILK Normally open jumper                                                                                                                                      
Q1   32.768                CRYSTAL8.0X3.8        CRYSTAL_8X3.8        Crystals                                                                                                                                                  
R1   10K                   R-US_R0805            R0805                RESISTOR, American symbol                                                                                                                                 
R2   10K                   R-US_R0805            R0805                RESISTOR, American symbol                                                                                                                                 
R3   1k                    R-US_R0805            R0805                RESISTOR, American symbol                                                                                                                                 
U$1  FIDUCIAL              FIDUCIAL              FIDUCIAL_1MM         For use by pick and place machines to calibrate the vision/machine, 1mm                                                                                   
U$3  FIDUCIAL              FIDUCIAL              FIDUCIAL_1MM         For use by pick and place machines to calibrate the vision/machine, 1mm                                                                                   
U2   MB85RC256VPF-G-JNERE2 FRAM_SOIC8_I2C        SOIC8_208MIL         I2C FRAM - SOIC8 Package
