2BRobots/skykontrolVending/Hardware/LevelSensor/BOM.txt

Part Value      Device            Package             Description                                                                                                     DESCRIPTION                                        HEIGHT  MANUFACTURER_NAME MANUFACTURER_PART_NUMBER MOUSER_PART_NUMBER MOUSER_PRICE-STOCK                                               PROD_ID    SF_SKU   
C1   100nF      C-USC0603K        C0603K              CAPACITOR, American symbol                                                                                                                                                                                                                                                                                                    
C2   1uF        C-USC0603K        C0603K              CAPACITOR, American symbol                                                                                                                                                                                                                                                                                                    
C3   470pF      C-USC0805K        C0805K              CAPACITOR, American symbol                                                                                                                                                                                                                                                                                                    
IC1  MP3V5050DP MP3V5050DP        SOP254P1753X991-8N  NXP - MP3V5050DP - PRESSURE SENSOR, 0-50KPA, SOP-8                                                              NXP - MP3V5050DP - PRESSURE SENSOR, 0-50KPA, SOP-8 9.906mm Nexperia          MP3V5050DP               841-MP3V5050DP     https://www.mouser.com/Search/Refine.aspx?Keyword=841-MP3V5050DP                     
J1              CONN_03-SCREW-5MM SCREWTERMINAL-5MM-3 Multi connection point. Often used as Generic Header-pin footprint for 0.1 inch spaced/style header connections                                                                                                                                                                                           CONN-10134 PRT-08433
U$2  FIDUCIAL   FIDUCIAL          FIDUCIAL_1MM        For use by pick and place machines to calibrate the vision/machine, 1mm                                                                                                                                                                                                                                                       
U$3  FIDUCIAL   FIDUCIAL          FIDUCIAL_1MM        For use by pick and place machines to calibrate the vision/machine, 1mm
