2BRobots/skykontrolVending/Hardware/SlotExpansion/BOM.txt

Part Value                        Device                       Package                      Description                                                                                                     MF MPN             OC_FARNELL OC_NEWARK PACKAGE PIC POGO POPULARITY PROD_ID    PROGRAMING SF_SKU    SMT SUPPLIER  TOLERANCE VALUE VOLTAGERATING
C1   100UF                        EEE-HA1E101XP-CASE-D8        CAPAE660X800N                Aluminum Electrolytic Capacitors,Surface Mount Type                                                                EEE-HA1E101XP   1973328    58T9236   CASE-D8                                                         PANASONIC ±20 %     100UF 25V          
C2   100nF                        C-USC0603K                   C0603K                       CAPACITOR, American symbol                                                                                                                                                                                                                                     
C3   100UF                        EEE-HA1E101XP-CASE-D8        CAPAE660X800N                Aluminum Electrolytic Capacitors,Surface Mount Type                                                                EEE-HA1E101XP   1973328    58T9236   CASE-D8                                                         PANASONIC ±20 %     100UF 25V          
C4   100nF                        C-USC0603K                   C0603K                       CAPACITOR, American symbol                                                                                                                                                                                                                                     
D1   MMSD301T                     DIODESOD-123                 SOD-123                      Diode                                                                                                                                                                                                                                                          
D2   MMSD301T                     DIODESOD-123                 SOD-123                      Diode                                                                                                                                                                                                                                                          
D3   MMSD301T                     DIODESOD-123                 SOD-123                      Diode                                                                                                                                                                                                                                                          
D4   MMSD301T                     DIODESOD-123                 SOD-123                      Diode                                                                                                                                                                                                                                                          
J1                                CONN_03-SCREW-5MM            SCREWTERMINAL-5MM-3          Multi connection point. Often used as Generic Header-pin footprint for 0.1 inch spaced/style header connections                                                                     CONN-10134            PRT-08433                                            
J2                                CONN_03-SCREW-5MM            SCREWTERMINAL-5MM-3          Multi connection point. Often used as Generic Header-pin footprint for 0.1 inch spaced/style header connections                                                                     CONN-10134            PRT-08433                                            
J3                                CONN_03-SCREW-5MM            SCREWTERMINAL-5MM-3          Multi connection point. Often used as Generic Header-pin footprint for 0.1 inch spaced/style header connections                                                                     CONN-10134            PRT-08433                                            
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
U$3  FIDUCIAL                     FIDUCIAL                     FIDUCIAL_1MM                 For use by pick and place machines to calibrate the vision/machine, 1mm                                                                                                                                                                                        
U2   PIC16F1847-I/SO              PIC16F1847-I/SO              SOIC127P1030X265-18N         IC, 18 Pin Flash Microcontrollers with XLP Technology-SOIC-18                                                      PIC16F1847-I/SO 1971870    23T3107   SOIC-18                                                         Microchip
