2BRobots/skykontrolVending/Hardware/USB Terminal/usbTerminal.brd

## EAGLE design Hardware/USB Terminal/usbTerminal.brd (2021-02-21)

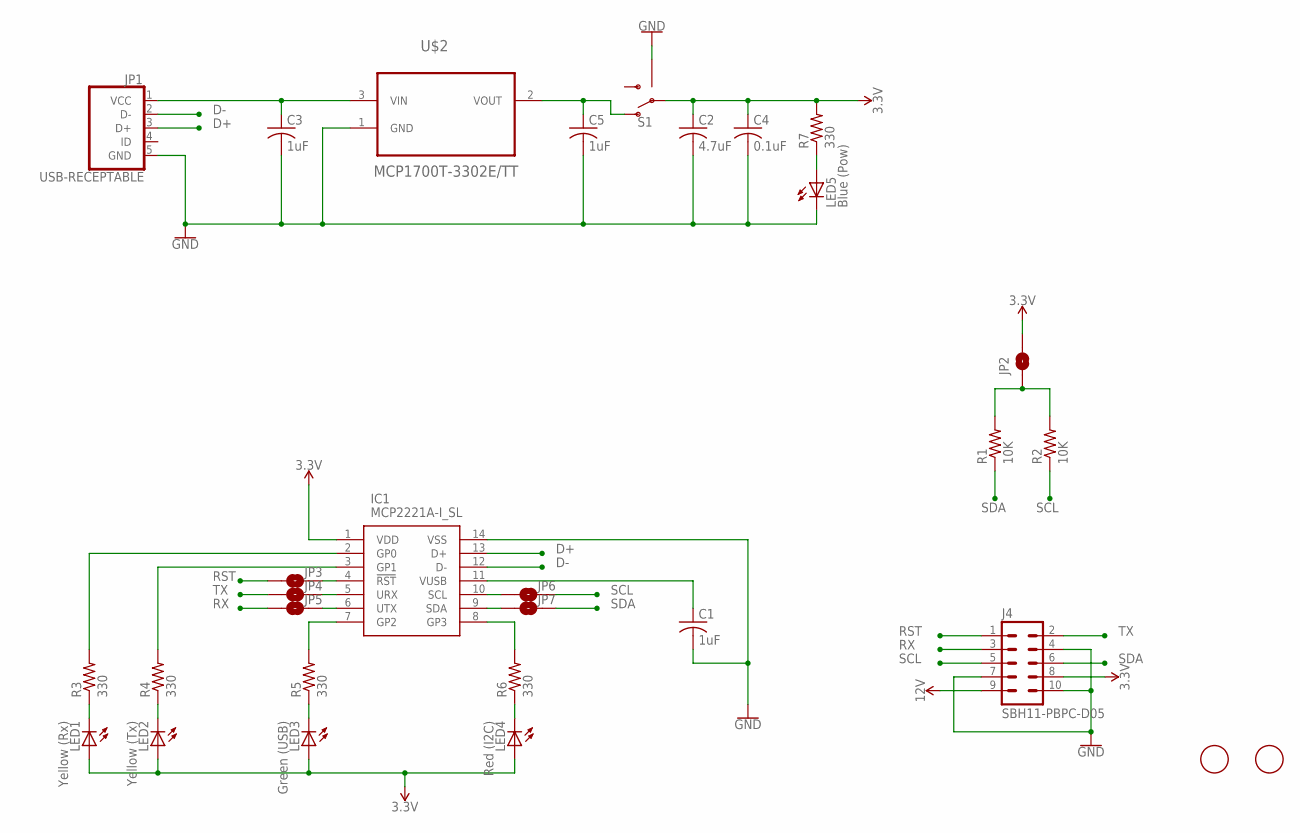
[picture p36: schematic usbTerminal.sch]

Parts:
C1, C3, C5: 1uF; C0603K
C2: 4.7uF; C0805K
C4: 0.1uF; C0603K
IC1: MCP2221A-I_SL; SOIC127P600X175-14N
J4: SBH11-PBPC-D05
JP1: USB-RECEPTABLE; FCI-10103594-0001LF
JP2, JP3, JP4, JP5, JP6, JP7: JUMPER-SMT_2_NO_SILK; SMT-JUMPER_2_NO_SILK
LED1: Yellow (Rx); CHIPLED_1206
LED2: Yellow (Tx); CHIPLED_1206
LED3: Green (USB); CHIPLED_1206
LED4: Red (I2C); CHIPLED_1206
LED5: Blue (Pow); CHIPLED_1206
R1, R2: 10K; R0805
R3, R4, R5, R6, R7: 330; R0805
S1: SWITCH-SPDT-SMD-RIGHT-ANGLE; SWITCH_SPST_SMD_A
U$1, U$3: FIDUCIAL; FIDUCIAL_1MM
U$2: MCP1700T-3302E/TT; SOT95P237X112-3N

Connections:
3.3V: C2.1, C4.1, IC1.1 (VDD), J4.8, JP2.2, LED1.A, LED2.A, LED3.A, LED4.A, R7.2, S1.2
12V: J4.9
D+: IC1.13 (D+), JP1.3 (D+)
D-: IC1.12 (D-), JP1.2 (D-)
GND: C1.2, C2.2, C3.2, C4.2, C5.2, IC1.14 (VSS), J4.4, J4.7, J4.10, JP1.5 (GND), LED5.C, S1.GND1 (GND), S1.GND2 (GND), S1.GND3 (GND), S1.GND4 (GND), U$2.1 (GND)
unnamed: IC1.4 (!RST), JP3.1
unnamed: C1.1, IC1.11 (VUSB)
unnamed: IC1.5 (URX), JP4.1
unnamed: JP2.1, R1.2, R2.2
unnamed: IC1.6 (UTX), JP5.1
unnamed: IC1.10 (SCL), JP6.2
unnamed: IC1.9 (SDA), JP7.2
unnamed: LED1.C, R3.1
unnamed: LED2.C, R4.1
unnamed: LED3.C, R5.1
unnamed: LED4.C, R6.1
unnamed: C3.1, JP1.1 (VCC), U$2.3 (VIN)
unnamed: LED5.A, R7.1
unnamed: IC1.7 (GP2), R5.2
unnamed: IC1.8 (GP3), R6.2
unnamed: IC1.3 (GP1), R4.2
unnamed: IC1.2 (GP0), R3.2
unnamed: C5.1, S1.1 (O), U$2.2 (VOUT)
RST: J4.1, JP3.2
RX: J4.3, JP5.2
SCL: J4.5, JP6.1, R2.1
SDA: J4.6, JP7.1, R1.1
TX: J4.2, JP4.2

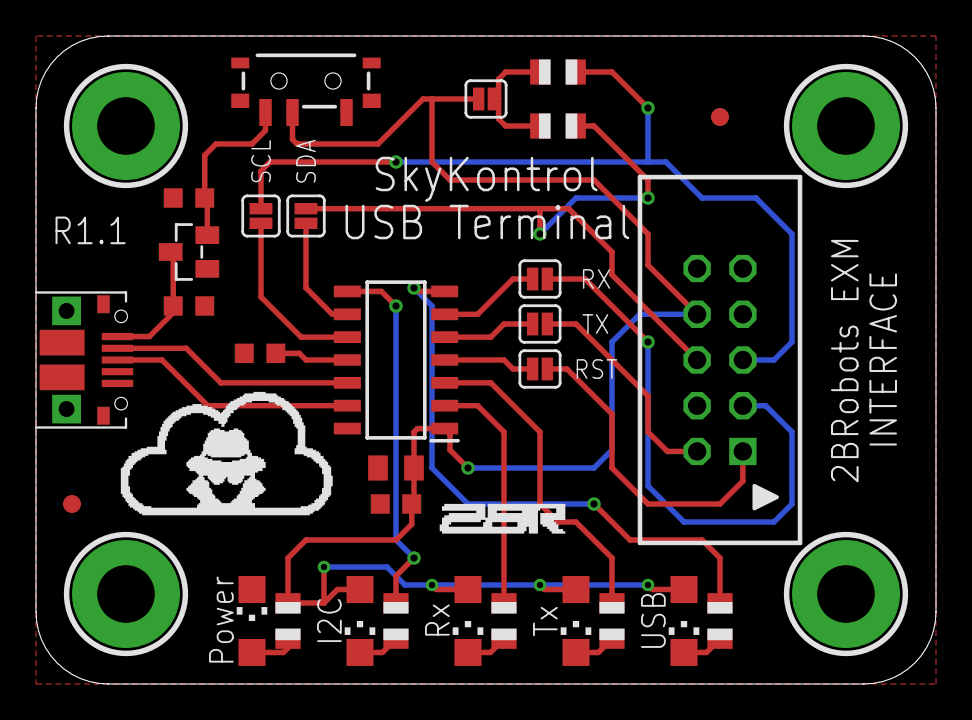
[picture p37: board usbTerminal.brd from above]

Board: 2 copper layers, 50.0 x 36.0 mm, 30 parts (0 on the bottom side), 27 nets.
