2BRobots/skykontrolVending/Hardware/WatchDog/SkyKontrol-watchdog.brd

## EAGLE design Hardware/WatchDog/SkyKontrol-watchdog.brd (2021-02-03)

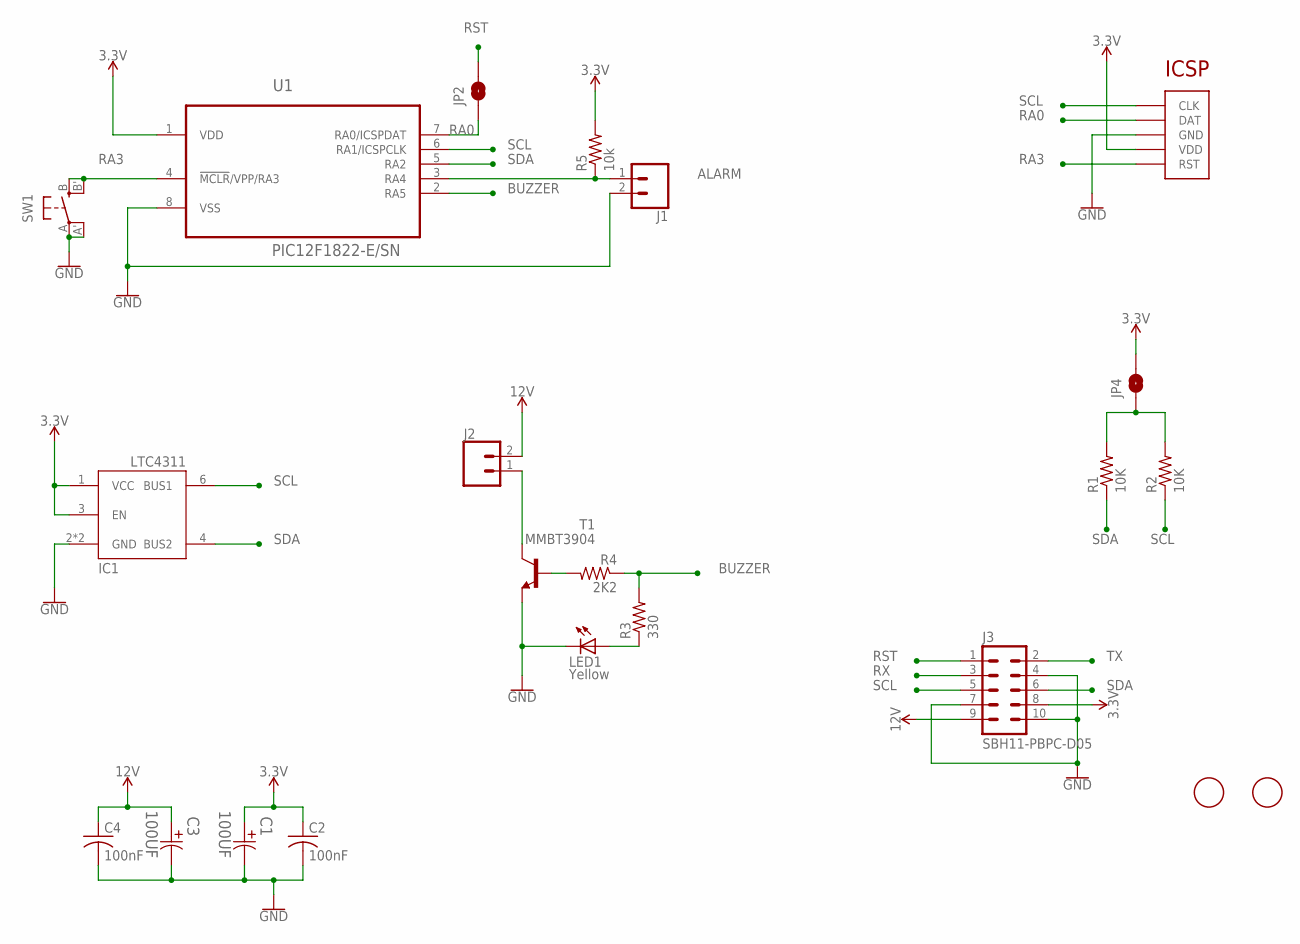
[picture p38: schematic SkyKontrol-watchdog.sch]

Parts:
C1, C3: 100UF; CAPAE660X800N
C2, C4: 100nF; C0603K
IC1: LTC4311_SC70; SC70-6L
J1, J2: CONN_025MM; SCREWTERMINAL-5MM-2
J3: SBH11-PBPC-D05
JP2, JP4: JUMPER-SMT_2_NO_SILK; SMT-JUMPER_2_NO_SILK
LED1: Yellow; CHIPLED_1206
R1, R2: 10K; R0805
R3: 330; R0805
R4: 2K2; R0805
R5: 10k; R0805
SW1: SPST_TACT-EVQQ2; EVQ-Q2
T1: MMBT3904; SOT23-BEC
U1: PIC12F1822-E/SN; SOIC127P600X175-8N
U$1, U$3: FIDUCIAL; FIDUCIAL_1MM
U$2: ICSP_POGO

Connections:
3.3V: C1.1, C2.1, IC1.1 (VCC), IC1.3 (EN), J3.8, JP4.2, R5.2, U1.1 (VDD), U$2.P$2 (VDD)
12V: C3.1, C4.1, J2.2, J3.9
ALARM: J1.1, R5.1, U1.3 (RA4)
BUZZER: R3.2, R4.1, U1.2 (RA5)
GND: C1.2, C2.2, C3.2, C4.2, IC1.2 (GND), IC1.5 (GND), J1.2, J3.4, J3.7, J3.10, LED1.C, SW1.A, SW1.A' (P1), T1.E, U1.8 (VSS), U$2.P$3 (GND)
unnamed: LED1.A, R3.1
unnamed: J2.1, T1.C
unnamed: JP4.1, R1.2, R2.2
unnamed: R4.2, T1.B
RA0: JP2.1, U1.7 (RA0/ICSPDAT), U$2.P$4 (DAT)
RA3: SW1.B (S), SW1.B' (S1), U1.4 (!MCLR!/VPP/RA3), U$2.P$1 (RST)
RST: J3.1, JP2.2
RX: J3.3
SCL: IC1.6 (BUS1), J3.5, R2.1, U1.6 (RA1/ICSPCLK), U$2.P$5 (CLK)
SDA: IC1.4 (BUS2), J3.6, R1.1, U1.5 (RA2)
TX: J3.2

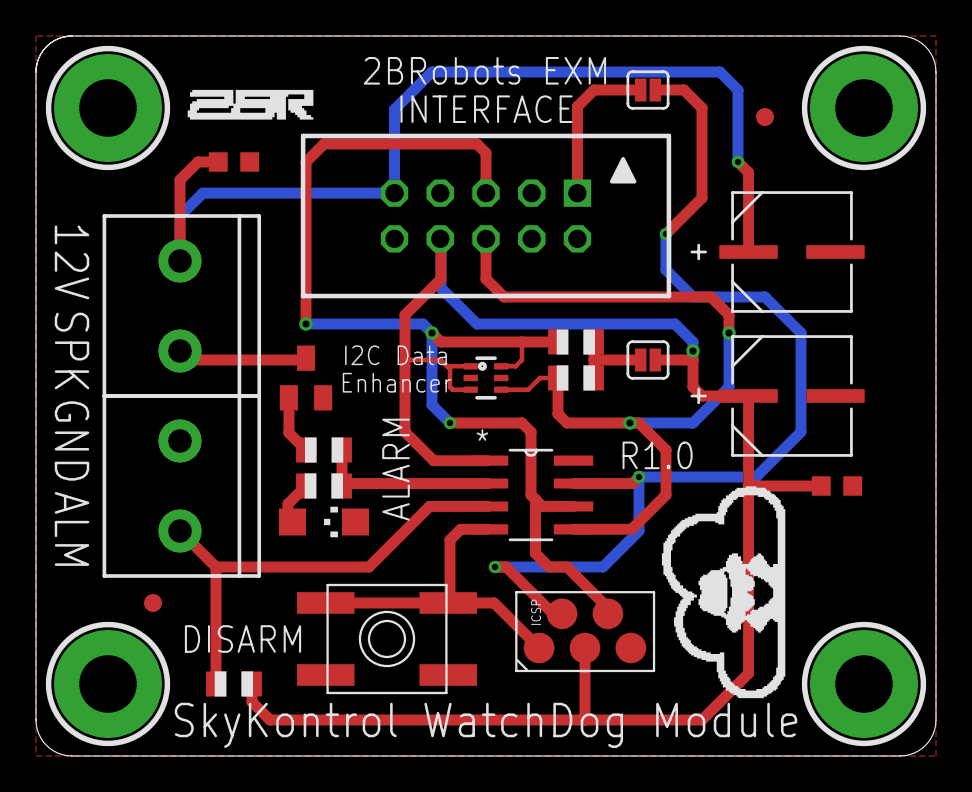
[picture p39: board SkyKontrol-watchdog.brd from above]

Board: 2 copper layers, 50.0 x 40.0 mm, 22 parts (0 on the bottom side), 14 nets.
