2BRobots/skykontrolVending/Hardware/PowerMeter/SkyKontrol-powerMeter.brd

## EAGLE design Hardware/PowerMeter/SkyKontrol-powerMeter.brd (2020-02-13)

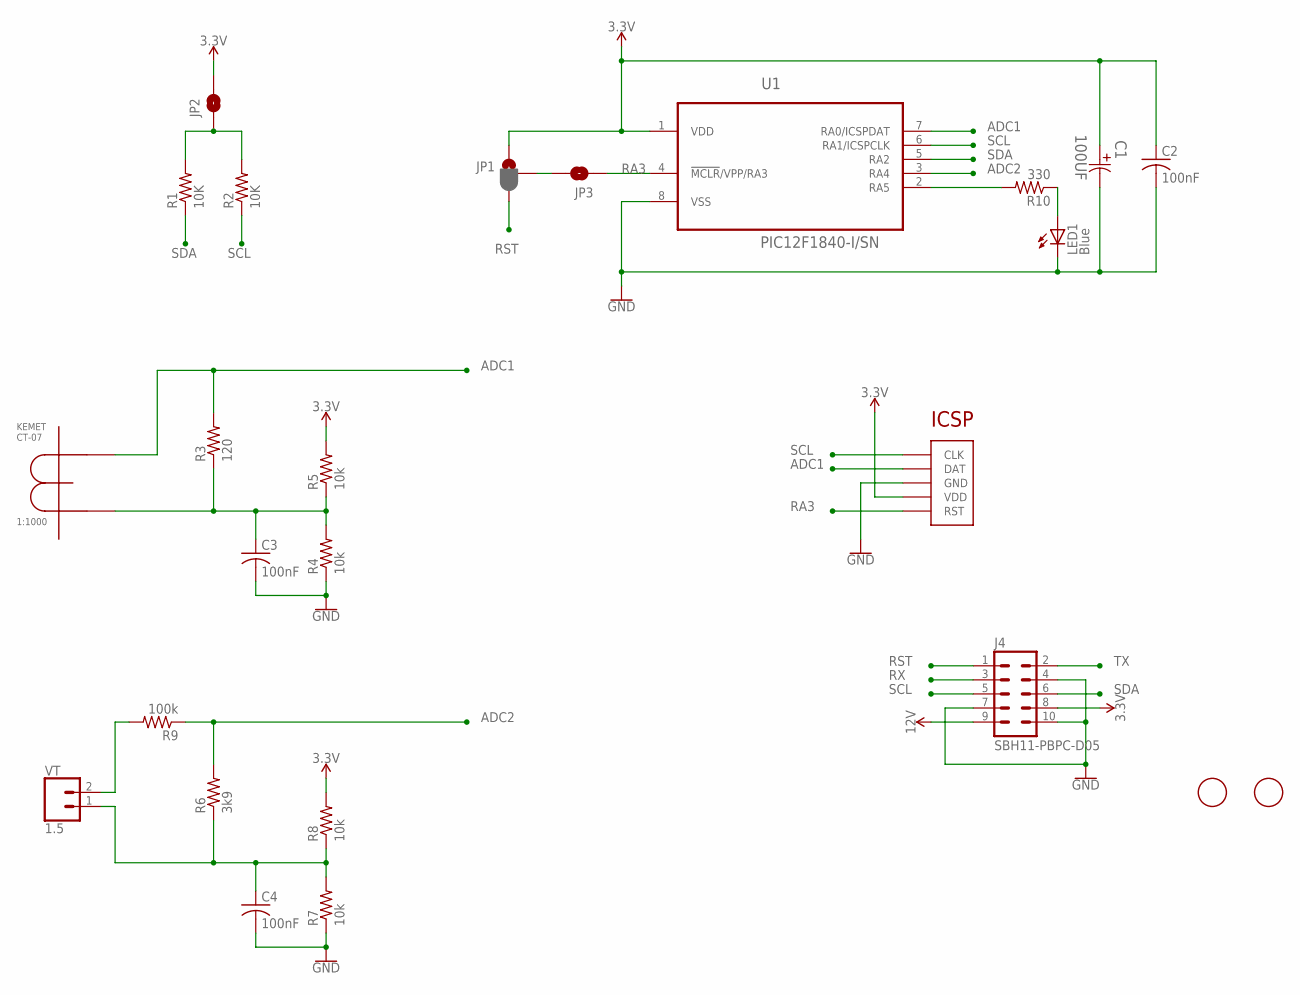
[picture p40: schematic SkyKontrol-powerMeter.sch]

Parts:
C1: 100UF; CAPAE660X800N
C2, C3, C4: 100nF; C0603K
J4: SBH11-PBPC-D05
JP1: JUMPER-SMT_3_1-NC_PASTE_SILK; SMT-JUMPER_3_1-NC_PASTE_SILK
JP2, JP3: JUMPER-SMT_2_NO_SILK; SMT-JUMPER_2_NO_SILK
LED1: Blue; CHIPLED_1206
R1, R2: 10K; R0805
R3: 120; R0805
R4, R5, R7, R8: 10k; R0805
R6: 3k9; R0805
R9: 100k; R0805
R10: 330; R0805
U1: PIC12F1840-I/SN; SOIC127P600X175-8N
U$1, U$3: FIDUCIAL; FIDUCIAL_1MM
U$2: ICSP_POGO
U$4: CT-07KEMET; CT-07
VT: 1.5; SCREWTERMINAL-5MM-2

Connections:
3.3V: C1.1, C2.1, J4.8, JP1.1, JP2.2, R5.2, R8.2, U1.1 (VDD), U$2.P$2 (VDD)
12V: J4.9
ADC1: R3.2, U1.7 (RA0/ICSPDAT), U$2.P$4 (DAT), U$4.P$1 (C1)
ADC2: R6.2, R9.1, U1.3 (RA4)
GND: C1.2, C2.2, C3.2, C4.2, J4.4, J4.7, J4.10, LED1.C, R4.1, R7.1, U1.8 (VSS), U$2.P$3 (GND)
unnamed: JP1.2, JP3.2
unnamed: C3.1, R3.1, R4.2, R5.1, U$4.P$2 (C2)
unnamed: R9.2, VT.2
unnamed: C4.1, R6.1, R7.2, R8.1, VT.1
unnamed: JP2.1, R1.2, R2.2
unnamed: R10.2, U1.2 (RA5)
unnamed: LED1.A, R10.1
RA3: JP3.1, U1.4 (!MCLR!/VPP/RA3), U$2.P$1 (RST)
RST: J4.1, JP1.3
RX: J4.3
SCL: J4.5, R2.1, U1.6 (RA1/ICSPCLK), U$2.P$5 (CLK)
SDA: J4.6, R1.1, U1.5 (RA2)
TX: J4.2

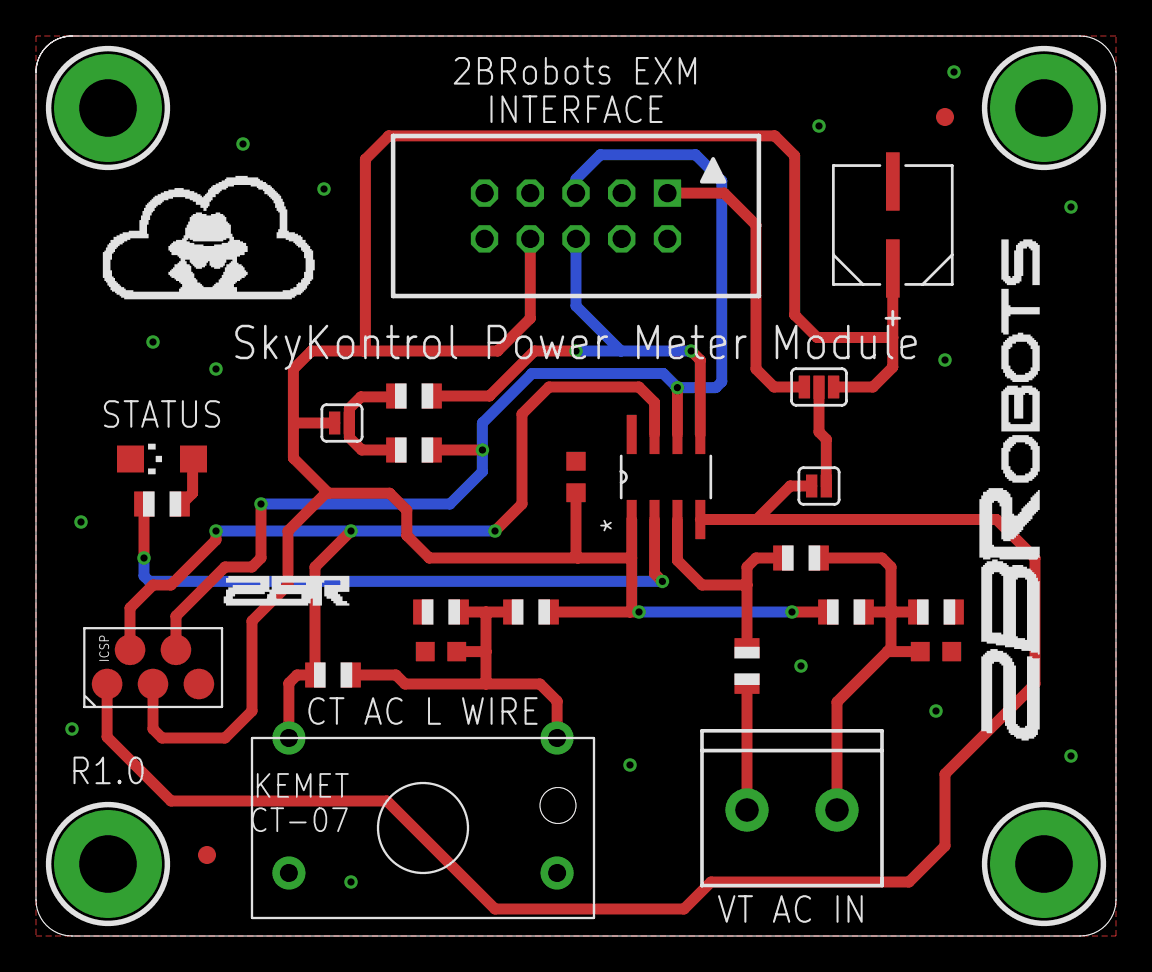
[picture p41: board SkyKontrol-powerMeter.brd from above]

Board: 2 copper layers, 60.0 x 50.0 mm, 25 parts (0 on the bottom side), 15 nets.
