2BRobots/skykontrolVending/Hardware/LevelSensor/LevelSensor.brd

## EAGLE design Hardware/LevelSensor/LevelSensor.brd (2020-01-12)

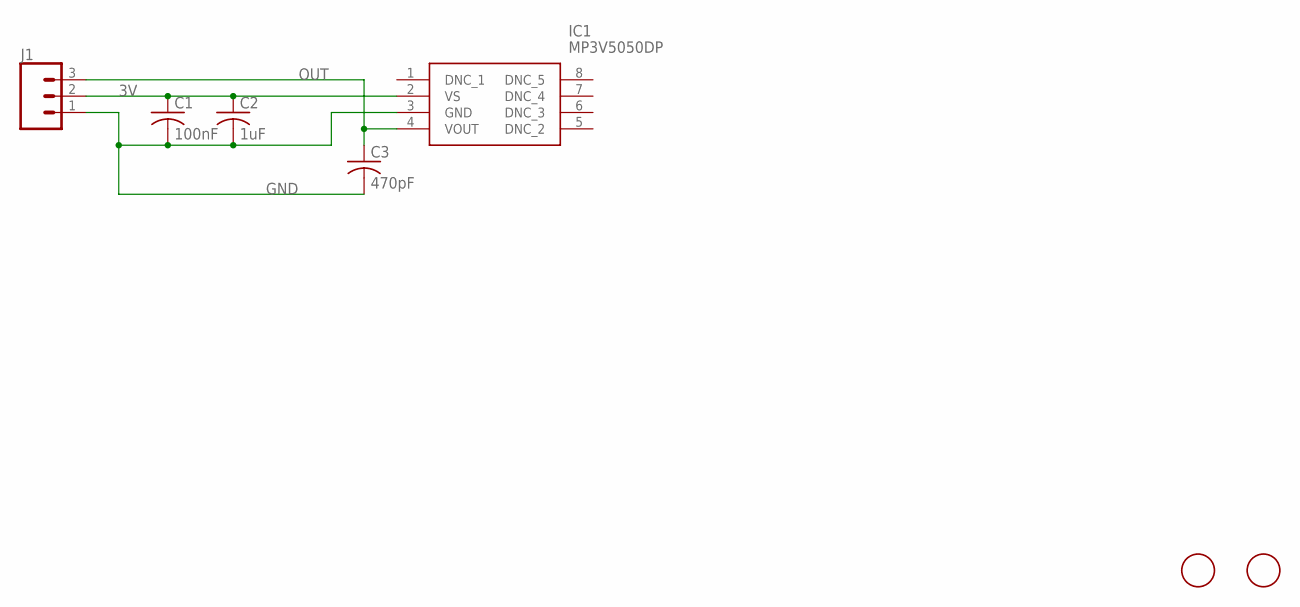
[picture p42: schematic LevelSensor.sch]

Parts:
C1: 100nF; C0603K
C2: 1uF; C0603K
C3: 470pF; C0805K
IC1: MP3V5050DP; SOP254P1753X991-8N
J1: CONN_03-SCREW-5MM; SCREWTERMINAL-5MM-3
U$2, U$3: FIDUCIAL; FIDUCIAL_1MM

Connections:
3V: C1.1, C2.1, IC1.2 (VS), J1.2
GND: C1.2, C2.2, C3.2, IC1.3 (GND), J1.1
OUT: C3.1, IC1.4 (VOUT), J1.3

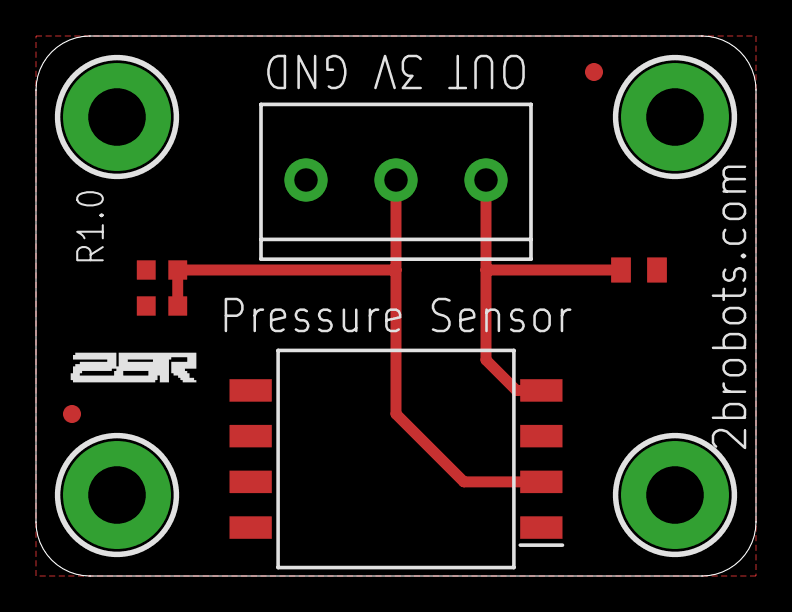
[picture p43: board LevelSensor.brd from above]

Board: 2 copper layers, 40.0 x 30.0 mm, 7 parts (0 on the bottom side), 3 nets.
