2BRobots/skykontrolVending/Hardware/SlotExpansion/SkyKontrol-slotExpansion.brd

## EAGLE design Hardware/SlotExpansion/SkyKontrol-slotExpansion.brd (2019-12-30)

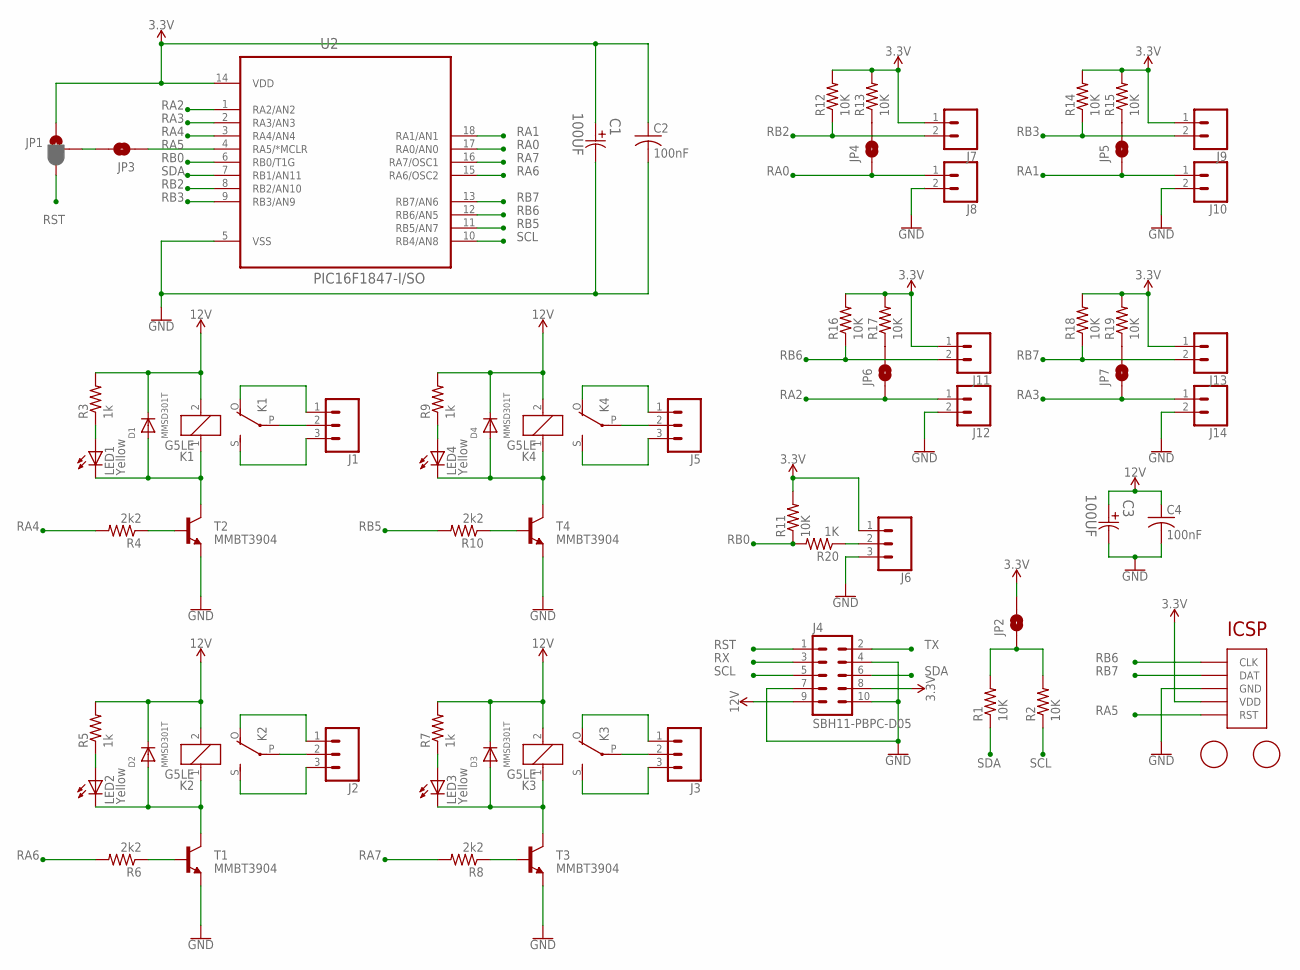
[picture p44: schematic SkyKontrol-slotExpansion.sch]

Parts:
C1, C3: 100UF; CAPAE660X800N
C2, C4: 100nF; C0603K
D1, D2, D3, D4: MMSD301T; SOD-123
J1, J2, J3, J5, J6: CONN_03-SCREW-5MM; SCREWTERMINAL-5MM-3
J4: SBH11-PBPC-D05
J7, J8, J9, J10, J11, J12, J13, J14: CONN_025MM; SCREWTERMINAL-5MM-2
JP1: JUMPER-SMT_3_1-NC_PASTE_SILK; SMT-JUMPER_3_1-NC_PASTE_SILK
JP2, JP3, JP4, JP5, JP6, JP7: JUMPER-SMT_2_NO_SILK; SMT-JUMPER_2_NO_SILK
K1, K2, K3, K4: G5LE
LED1, LED2, LED3, LED4: Yellow; CHIPLED_1206
R1, R2, R11, R12, R13, R14, R15, R16, R17, R18, R19: 10K; R0805
R3, R5, R7, R9: 1k; R0805
R4, R6, R8, R10: 2k2; R0805
R20: 1K; R0805
T1, T2, T3, T4: MMBT3904; SOT23-BEC
U2: PIC16F1847-I/SO; SOIC127P1030X265-18N
U$1, U$3: FIDUCIAL; FIDUCIAL_1MM
U$2: ICSP_POGO

Connections:
3.3V: C1.1, C2.1, J4.8, J6.1, J7.1, J9.1, J11.1, J13.1, JP1.1, JP2.2, R11.2, R12.2, R13.2, R14.2, R15.2, R16.2, R17.2, R18.2, R19.2, U2.14 (VDD), U$2.P$2 (VDD)
12V: C3.1, C4.1, D1.C, D2.C, D3.C, D4.C, J4.9, K1.2, K2.2, K3.2, K4.2, R3.2, R5.2, R7.2, R9.2
GND: C1.2, C2.2, C3.2, C4.2, J4.4, J4.7, J4.10, J6.3, J8.2, J10.2, J12.2, J14.2, T1.E, T2.E, T3.E, T4.E, U2.5 (VSS), U$2.P$3 (GND)
unnamed: JP1.2, JP3.2
unnamed: J1.2, K1.P
unnamed: J1.3, K1.S
unnamed: J1.1, K1.O
unnamed: JP2.1, R1.2, R2.2
unnamed: D1.A, K1.1, LED1.C, T2.C
unnamed: J2.2, K2.P
unnamed: J2.3, K2.S
unnamed: LED1.A, R3.1
unnamed: R4.1, T2.B
unnamed: J6.2, R20.1
unnamed: J2.1, K2.O
unnamed: D2.A, K2.1, LED2.C, T1.C
unnamed: LED2.A, R5.1
unnamed: R6.1, T1.B
unnamed: J3.2, K3.P
unnamed: J3.3, K3.S
unnamed: J3.1, K3.O
unnamed: D3.A, K3.1, LED3.C, T3.C
unnamed: LED3.A, R7.1
unnamed: R8.1, T3.B
unnamed: J5.2, K4.P
unnamed: J5.3, K4.S
unnamed: J5.1, K4.O
unnamed: D4.A, K4.1, LED4.C, T4.C
unnamed: LED4.A, R9.1
unnamed: R10.1, T4.B
unnamed: JP4.2, R13.1
unnamed: JP5.2, R15.1
unnamed: JP6.2, R17.1
unnamed: JP7.2, R19.1
RA0: J8.1, JP4.1, U2.17 (RA0/AN0)
RA1: J10.1, JP5.1, U2.18 (RA1/AN1)
RA2: J12.1, JP6.1, U2.1 (RA2/AN2)
RA3: J14.1, JP7.1, U2.2 (RA3/AN3)
RA4: R4.2, U2.3 (RA4/AN4)
RA5: JP3.1, U2.4 (RA5/*MCLR), U$2.P$1 (RST)
RA6: R6.2, U2.15 (RA6/OSC2)
RA7: R8.2, U2.16 (RA7/OSC1)
RB0: R11.1, R20.2, U2.6 (RB0/T1G)
RB2: J7.2, R12.1, U2.8 (RB2/AN10)
RB3: J9.2, R14.1, U2.9 (RB3/AN9)
RB5: R10.2, U2.11 (RB5/AN7)
RB6: J11.2, R16.1, U2.12 (RB6/AN5), U$2.P$5 (CLK)
RB7: J13.2, R18.1, U2.13 (RB7/AN6), U$2.P$4 (DAT)
RST: J4.1, JP1.3
RX: J4.3
SCL: J4.5, R2.1, U2.10 (RB4/AN8)
SDA: J4.6, R1.1, U2.7 (RB1/AN11)
TX: J4.2

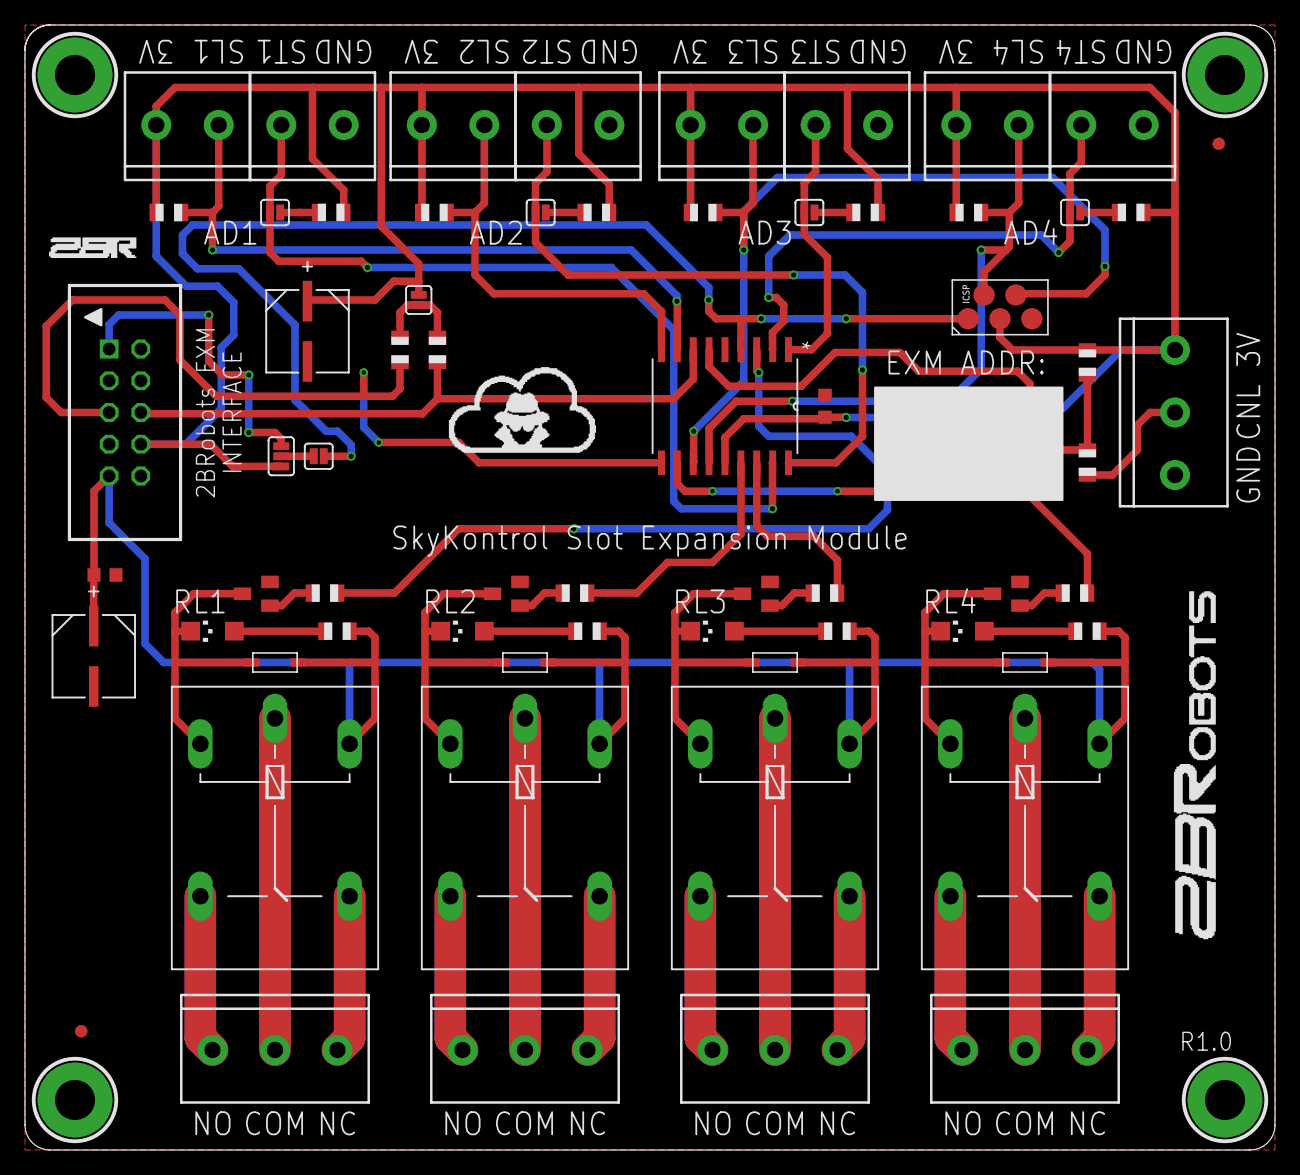
[picture p45: board SkyKontrol-slotExpansion.brd from above]

Board: 2 copper layers, 100.0 x 90.0 mm, 65 parts (0 on the bottom side), 51 nets.
