2BRobots/skykontrolVending/Hardware/SmartDisplay/SkyKontrol-smartDisplay.brd

## EAGLE design Hardware/SmartDisplay/SkyKontrol-smartDisplay.brd (2020-01-12)

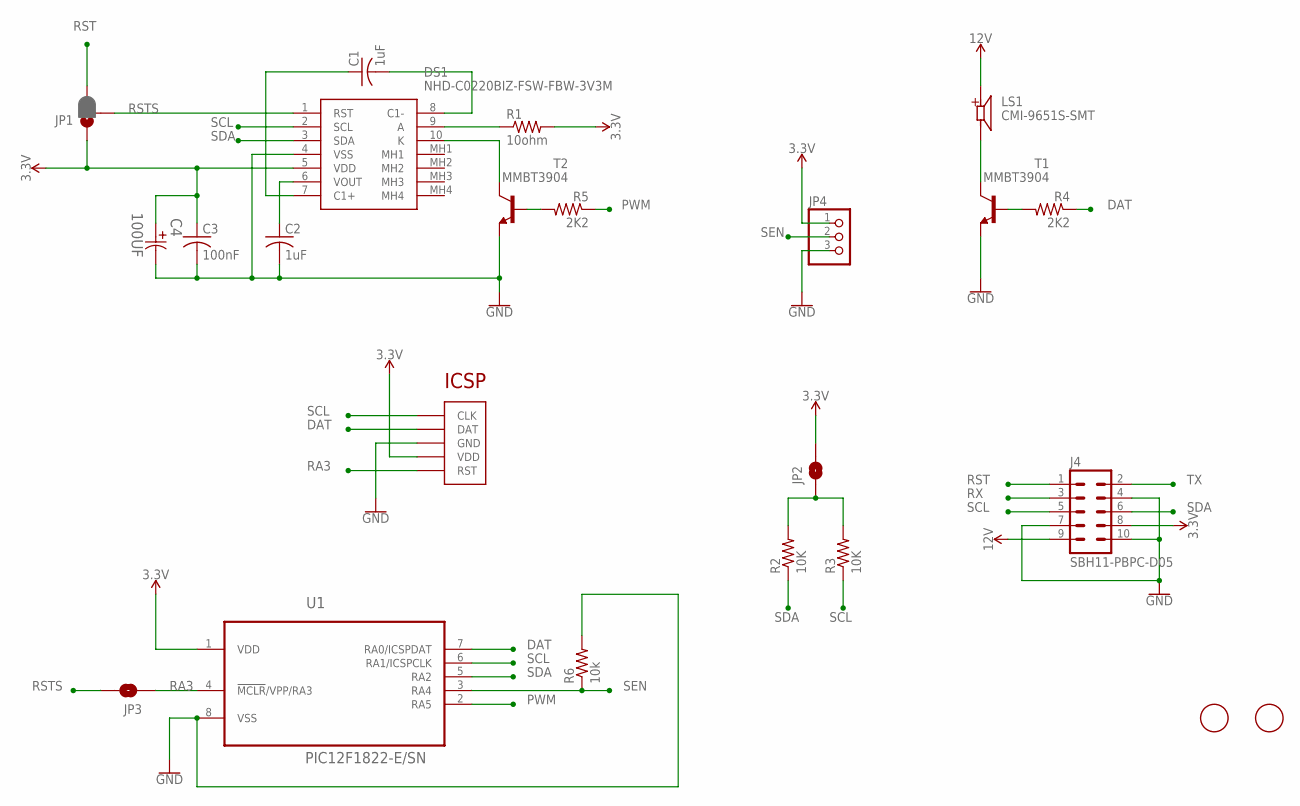
[picture p46: schematic SkyKontrol-smartDisplay.sch]

Parts:
C1, C2: 1uF; C0603K
C3: 100nF; C0603K
C4: 100UF; CAPAE660X800N
DS1: NHD-C0220BIZ-FSW-FBW-3V3M; NHDC0220BIZFSWFBW3V3M
J4: SBH11-PBPC-D05
JP1: JUMPER-SMT_3_1-NC_PASTE_SILK; SMT-JUMPER_3_1-NC_PASTE_SILK
JP2, JP3: JUMPER-SMT_2_NO_SILK; SMT-JUMPER_2_NO_SILK
JP4: PINHD-1X3CB; 1X03-CLEANBIG
LS1: CMI-9651S-SMT; CUI_CMI-9651S-SMT
R1: 10ohm; R0805
R2, R3: 10K; R0805
R4, R5: 2K2; R0805
R6: 10k; R0805
T1, T2: MMBT3904; SOT23-BEC
U1: PIC12F1822-E/SN; SOIC127P600X175-8N
U$1, U$3: FIDUCIAL; FIDUCIAL_1MM
U$2: ICSP_POGO

Connections:
3.3V: C3.1, C4.1, DS1.5 (VDD), J4.8, JP1.1, JP2.2, JP4.1, R1.2, U1.1 (VDD), U$2.P$2 (VDD)
12V: J4.9, LS1.P
DAT: R4.1, U1.7 (RA0/ICSPDAT), U$2.P$4 (DAT)
GND: C2.2, C3.2, C4.2, DS1.4 (VSS), J4.4, J4.7, J4.10, JP4.3, R6.2, T1.E, T2.E, U1.8 (VSS), U$2.P$3 (GND)
unnamed: C2.1, DS1.6 (VOUT)
unnamed: C1.2, DS1.8 (C1-)
unnamed: C1.1, DS1.7 (C1+)
unnamed: DS1.9 (A), R1.1
unnamed: JP2.1, R2.2, R3.2
unnamed: LS1.N, T1.C
unnamed: R4.2, T1.B
unnamed: DS1.10 (K), T2.C
unnamed: R5.2, T2.B
PWM: R5.1, U1.2 (RA5)
RA3: JP3.1, U1.4 (!MCLR!/VPP/RA3), U$2.P$1 (RST)
RST: J4.1, JP1.3
RSTS: DS1.1 (RST), JP1.2, JP3.2
RX: J4.3
SCL: DS1.2 (SCL), J4.5, R3.1, U1.6 (RA1/ICSPCLK), U$2.P$5 (CLK)
SDA: DS1.3 (SDA), J4.6, R2.1, U1.5 (RA2)
SEN: JP4.2, R6.1, U1.3 (RA4)
TX: J4.2

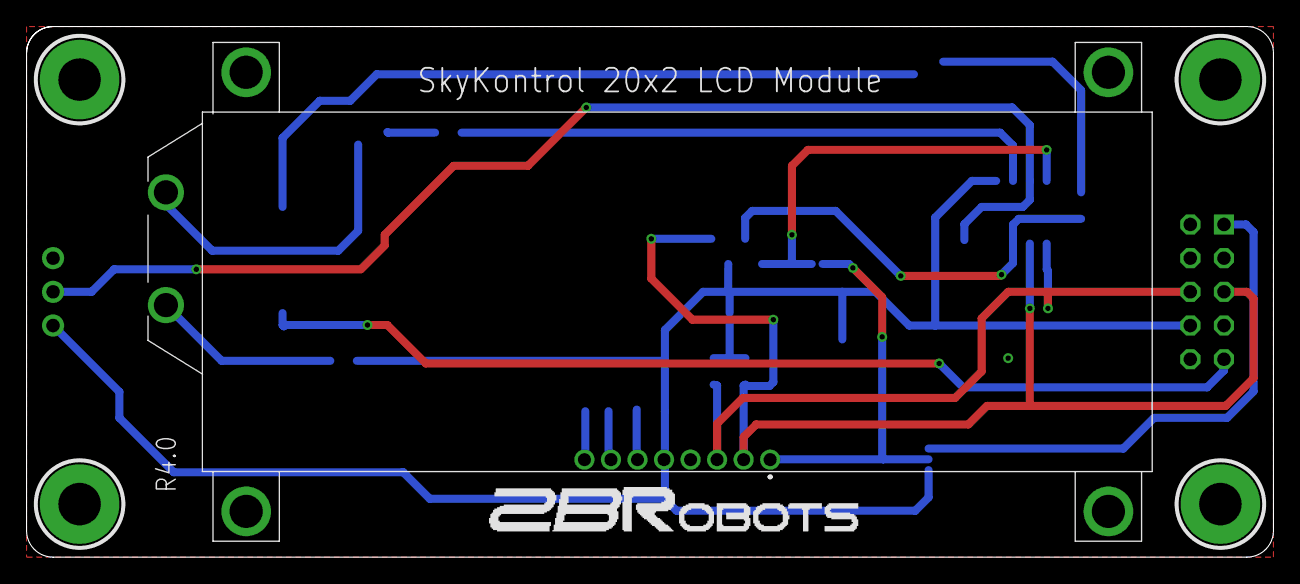
[picture p47: board SkyKontrol-smartDisplay.brd from above]

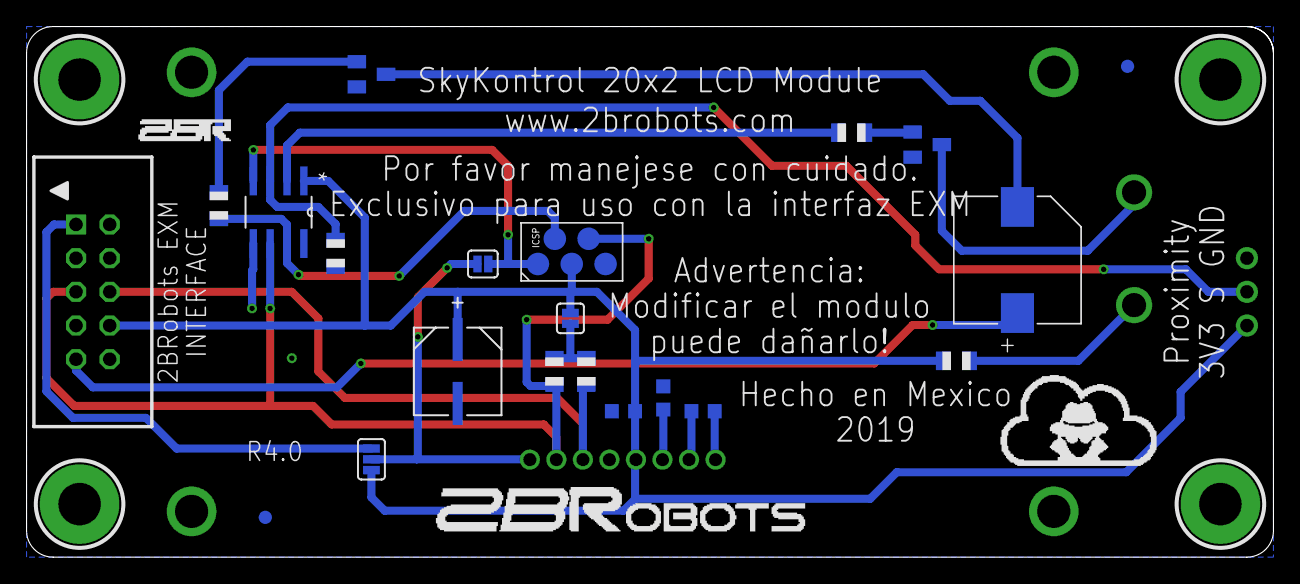
[picture p48: board SkyKontrol-smartDisplay.brd from below]

Board: 2 copper layers, 94.0 x 40.0 mm, 23 parts (21 on the bottom side), 20 nets.
