2BRobots/skykontrolVending/Hardware/IotController/SkyKontrol-IotController.brd

## EAGLE design Hardware/IotController/SkyKontrol-IotController.brd (2020-01-12)

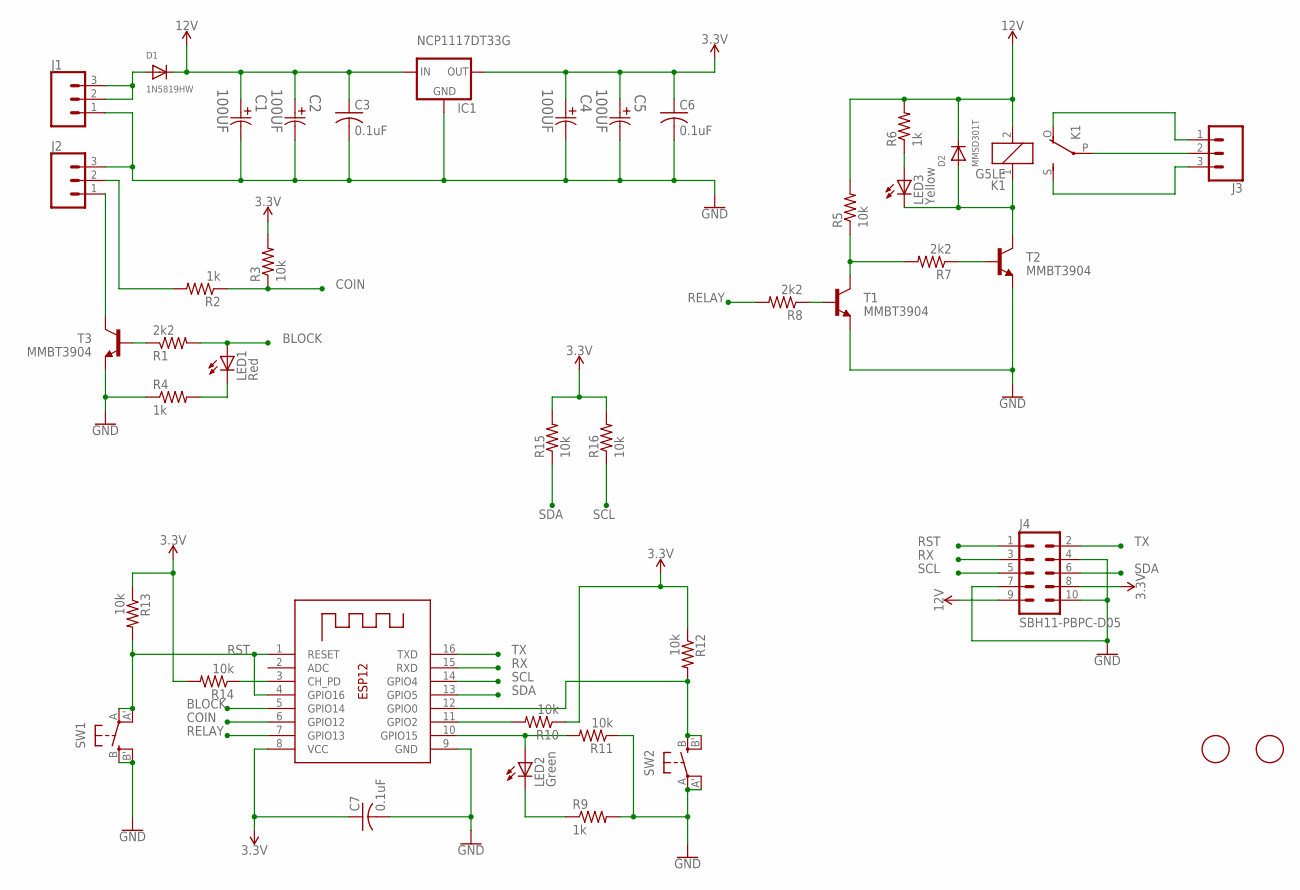
[picture p49: schematic SkyKontrol-IotController.sch]

Parts:
C1, C2, C4, C5: 100UF; CAPAE660X800N
C3, C6, C7: 0.1uF; C0603K
D1: 1N5819HW; SOD-123
D2: MMSD301T; SOD-123
IC1: NCP1117DT33G; TO252
J1, J2, J3: CONN_03-SCREW-5MM; SCREWTERMINAL-5MM-3
J4: SBH11-PBPC-D05
K1: G5LE
LED1: Red; CHIPLED_1206
LED2: Green; CHIPLED_1206
LED3: Yellow; CHIPLED_1206
R1, R7, R8: 2k2; R0805
R2, R4, R6, R9: 1k; R0805
R3, R5, R10, R11, R12, R13, R14, R15, R16: 10k; R0805
SW1, SW2: SPST_TACT-EVQQ2; EVQ-Q2
T1, T2, T3: MMBT3904; SOT23-BEC
U$1, U$2: FIDUCIAL; FIDUCIAL_1MM
X1: ESP-12

Connections:
3.3V: C4.1, C5.1, C6.1, C7.1, IC1.3 (OUT), J4.8, R3.2, R10.1, R12.1, R13.1, R14.2, R15.2, R16.2, X1.8 (VCC)
12V: C1.1, C2.1, C3.1, D1.C, D2.C, IC1.2 (IN), J4.9, K1.2, R5.2, R6.2
BLOCK: LED1.A, R1.2, X1.5 (GPIO14)
COIN: R2.1, R3.1, X1.6 (GPIO12)
GND: C1.2, C2.2, C3.2, C4.2, C5.2, C6.2, C7.2, IC1.1 (GND), J1.1, J2.3, J4.4, J4.7, J4.10, R4.1, R9.2, R11.1, SW1.B (S), SW1.B' (S1), SW2.A, SW2.A' (P1), T1.E, T2.E, T3.E, X1.9 (GND)
unnamed: LED1.C, R4.2
unnamed: J3.2, K1.P
unnamed: J2.1, T3.C
unnamed: J3.3, K1.S
unnamed: J3.1, K1.O
unnamed: D2.A, K1.1, LED3.C, T2.C
unnamed: J2.2, R2.2
unnamed: LED3.A, R6.1
unnamed: R7.1, T2.B
unnamed: R5.1, R7.2, T1.C
unnamed: R8.1, T1.B
unnamed: R1.1, T3.B
unnamed: R14.1, X1.3 (CH_PD)
unnamed: R12.2, SW2.B (S), SW2.B' (S1), X1.12 (GPIO0)
unnamed: D1.A, J1.2, J1.3
unnamed: LED2.C, R9.1
unnamed: LED2.A, R11.2, X1.10 (GPIO15)
unnamed: R10.2, X1.11 (GPIO2)
RELAY: R8.2, X1.7 (GPIO13)
RST: J4.1, R13.2, SW1.A, SW1.A' (P1), X1.1 (RESET), X1.4 (GPIO16)
RX: J4.3, X1.15 (RXD)
SCL: J4.5, R16.1, X1.14 (GPIO4)
SDA: J4.6, R15.1, X1.13 (GPIO5)
TX: J4.2, X1.16 (TXD)

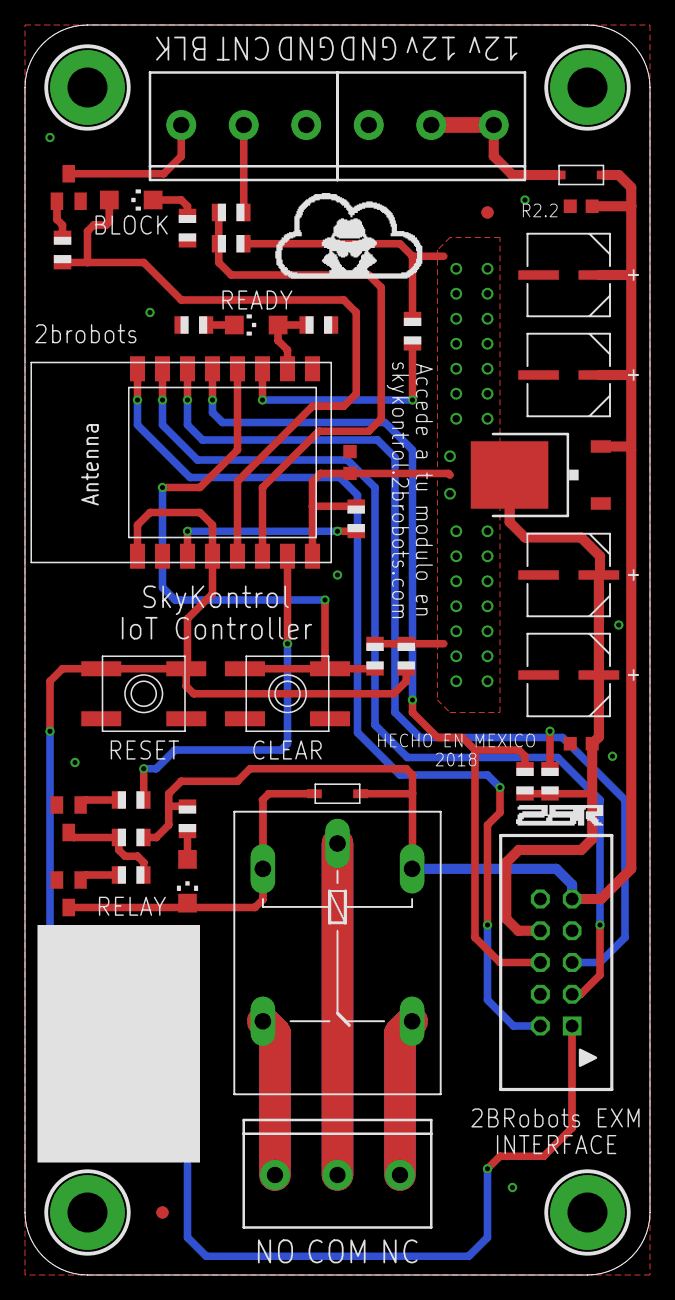
[picture p50: board SkyKontrol-IotController.brd from above]

Board: 2 copper layers, 50.0 x 100.0 mm, 42 parts (0 on the bottom side), 29 nets.
