2BRobots/skykontrolVending/Hardware/Datalogger/SkyKontrol-datalogger.brd

## EAGLE design Hardware/Datalogger/SkyKontrol-datalogger.brd (2020-01-12)

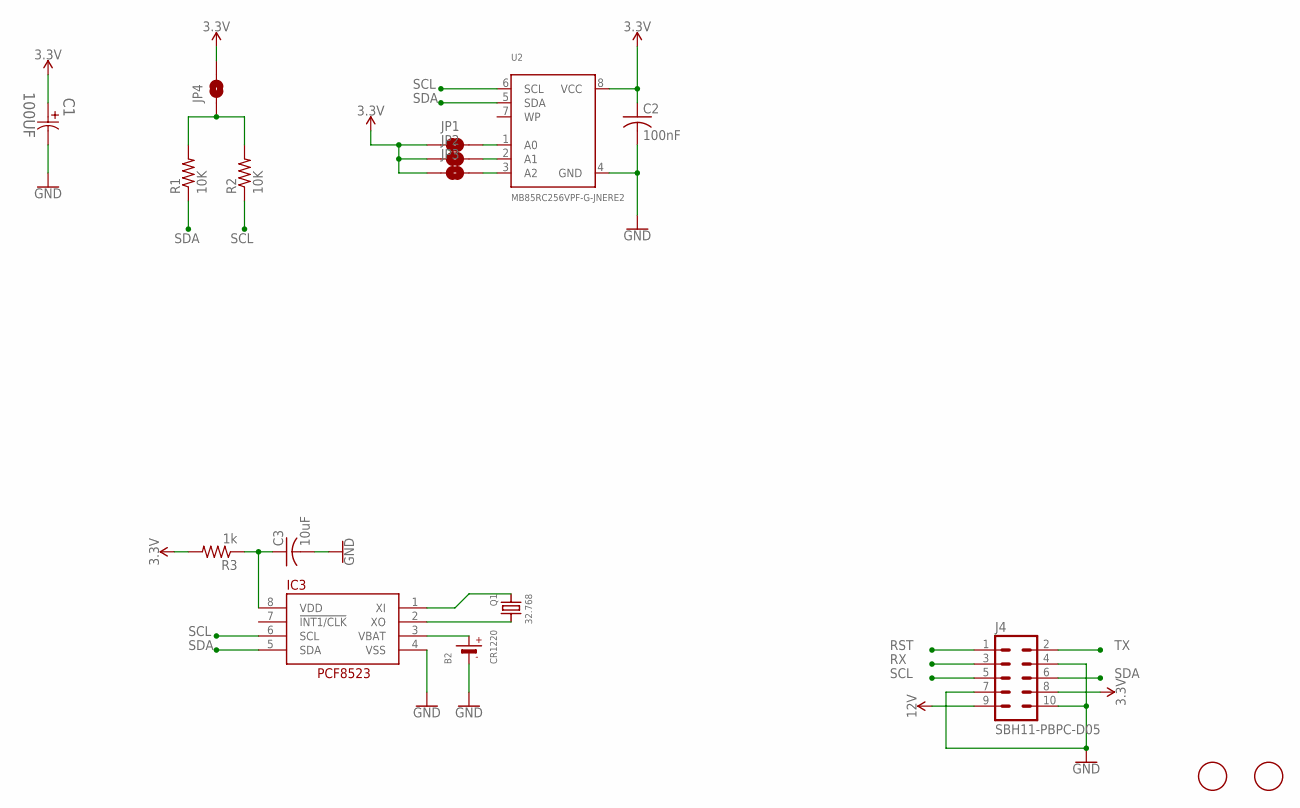
[picture p51: schematic SkyKontrol-datalogger.sch]

Parts:
B2: CR1220
C1: 100UF; CAPAE660X800N
C2: 100nF; C0603K
C3: 10uF; C0805K
IC3: RTC_PCF8523T; SOIC8_150MIL
J4: SBH11-PBPC-D05
JP1, JP2, JP3, JP4: JUMPER-SMT_2_NO_SILK; SMT-JUMPER_2_NO_SILK
Q1: 32.768; CRYSTAL_8X3.8
R1, R2: 10K; R0805
R3: 1k; R0805
U2: MB85RC256VPF-G-JNERE2; SOIC8_208MIL
U$1, U$3: FIDUCIAL; FIDUCIAL_1MM

Connections:
3.3V: C1.1, C2.1, J4.8, JP1.1, JP2.1, JP3.1, JP4.2, R3.2, U2.8 (VCC)
12V: J4.9
GND: B2.-, C1.2, C2.2, C3.2, IC3.4 (VSS), J4.4, J4.7, J4.10, U2.4 (GND)
unnamed: JP1.2, U2.1 (A0)
unnamed: JP2.2, U2.2 (A1)
unnamed: C3.1, IC3.8 (VDD), R3.1
unnamed: JP3.2, U2.3 (A2)
unnamed: JP4.1, R1.2, R2.2
unnamed: IC3.1 (XI), Q1.P$1 (1)
unnamed: IC3.2 (XO), Q1.P$4 (2)
RST: J4.1
RX: J4.3
SCL: IC3.6 (SCL), J4.5, R2.1, U2.6 (SCL)
SDA: IC3.5 (SDA), J4.6, R1.1, U2.5 (SDA)
TX: J4.2
VBAT1: B2.+$1 (+), IC3.3 (VBAT)
