2BRobots/skykontrolVending/Hardware/Datalogger/SkyKontrol-datalogger.brd

## EAGLE design Hardware/Datalogger/SkyKontrol-datalogger.brd (continued)

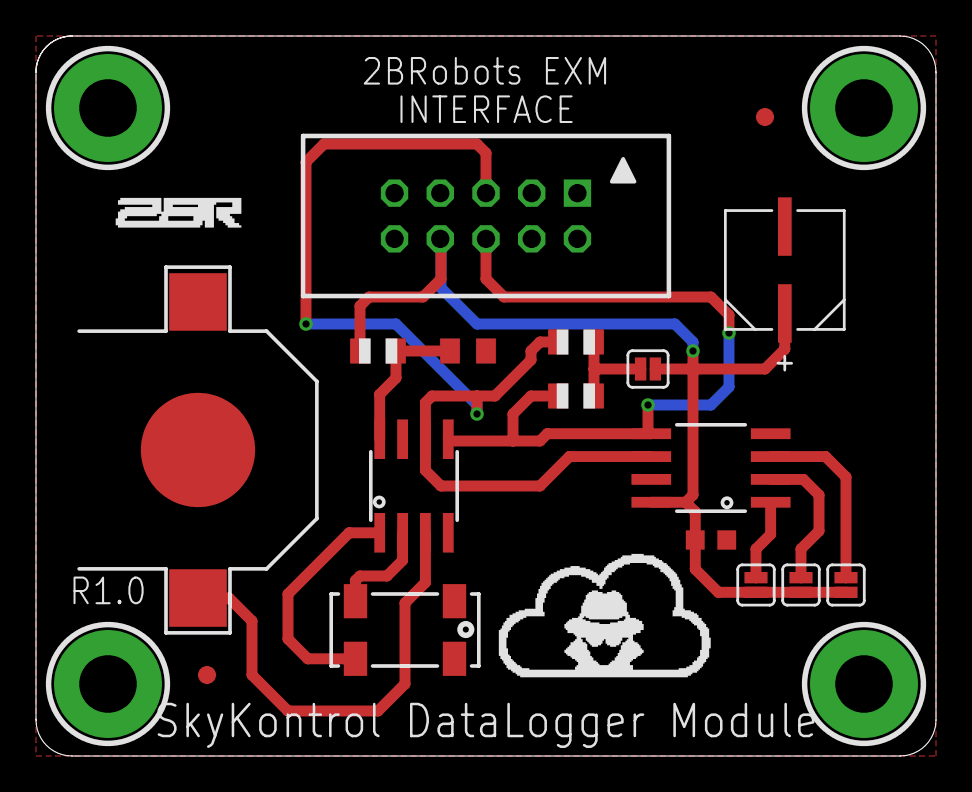
[picture p52: board SkyKontrol-datalogger.brd from above]

Board: 2 copper layers, 50.0 x 40.0 mm, 17 parts (0 on the bottom side), 12 nets.
