2BRobots/skykontrolVending/Hardware/WatchDog/firmware/main.c

/* 
 * File:   main.c
 * Author: dannimakes
 *
 * Created on 11 de enero de 2020, 06:20 PM
 */

// PIC12LF1822 Configuration Bit Settings

// CONFIG1
#pragma config FOSC = INTOSC    // Oscillator Selection (INTOSC oscillator: I/O function on CLKIN pin)
#pragma config WDTE = ON        // Watchdog Timer Enable (WDT enabled)
#pragma config PWRTE = ON       // Power-up Timer Enable (PWRT enabled)
#pragma config MCLRE = ON       // MCLR Pin Function Select (MCLR/VPP pin function is RESET)
#pragma config CP = OFF         // Flash Program Memory Code Protection (Program memory code protection is disabled)
#pragma config CPD = OFF        // Data Memory Code Protection (Data memory code protection is disabled)
#pragma config BOREN = ON       // Brown-out Reset Enable (Brown-out Reset enabled)
#pragma config CLKOUTEN = OFF   // Clock Out Enable (CLKOUT function is disabled. I/O or oscillator function on the CLKOUT pin)
#pragma config IESO = OFF       // Internal/External Switchover (Internal/External Switchover mode is disabled)
#pragma config FCMEN = OFF      // Fail-Safe Clock Monitor Enable (Fail-Safe Clock Monitor is disabled)

// CONFIG2
#pragma config WRT = OFF        // Flash Memory Self-Write Protection (Write protection off)
#pragma config PLLEN = ON       // PLL Enable (4x PLL enabled)
#pragma config STVREN = ON      // Stack Overflow/Underflow Reset Enable (Stack Overflow or Underflow will cause a Reset)
#pragma config BORV = LO        // Brown-out Reset Voltage Selection (Brown-out Reset Voltage (Vbor), low trip point selected.)
#pragma config LVP = OFF        // Low-Voltage Programming Enable (High-voltage on MCLR/VPP must be used for programming)

// Includes and definitions

#define _XTAL_FREQ 32000000
#define DEVICE_ID 0x01
#define I2C_slave_address 0x3D // any value from 0 to 127, this will be the default address
#define timeout 20000 //default ms for proximity detection clearing

#include <stdio.h>
#include <stdlib.h>
#include <xc.h>

// Global variables declation

volatile union _I2C_buffer {

    struct _data {
        unsigned char ID;
        unsigned char RESET;
        unsigned char DETECTED;
        unsigned long TIMEOUT;
        unsigned long REMAIN;
        unsigned int BEEP;
        unsigned int BRIGHTNESS;
    } data;
    unsigned char byte[];
} I2C_buffer;

const unsigned char RX_ELMNTS = sizeof (I2C_buffer);
unsigned char first_i2c = 1;
unsigned char index_i2c = 0;
unsigned char trigger = 0;
unsigned char pulses = 0;
unsigned char pulseLenght = 0;


// Interrupts

void __interrupt isr() {

    if (INTCONbits.IOCIF == 1 && IOCAFbits.IOCAF4 == 1) //interrupt on change on RA4 triggered
    {
        INTCONbits.IOCIE = 0; //disable on change interrupts
        trigger = 1;
        IOCAFbits.IOCAF4 = 0; //clear interrupt flag
        INTCONbits.IOCIE = 1; //enable on change interrupts
    }

    if (PIR1bits.TMR1IF == 1) //timer1 interrupt, called every 65.536ms
    {
        INTCONbits.IOCIE = 0; //disable on change interrupts
        T1CONbits.TMR1ON = 0; //stop timer1
        if (trigger == 1 && PORTAbits.RA4 == 1) //validate pulse lenght when it triggers
        {
            pulseLenght++;
            if (pulseLenght >= 3) //if lenght is enought increment pulses
            {
                pulseLenght = 0;
                trigger = 0;
                pulses++;
            }
        } else {
            trigger = 0;
            pulseLenght = 0;
        }
        if (pulses > 2) //if minimun pulses are present then check proximity detectetion
        {
            I2C_buffer.data.DETECTED = 1;
            I2C_buffer.data.REMAIN = I2C_buffer.data.TIMEOUT;
            pulses = 0;
        }
        INTCONbits.IOCIE = 1; //enable on change interrupts
        PIR1bits.TMR1IF = 0; //clear interrutp flag
        T1CONbits.TMR1ON = 1; //start timer1
    }

    static unsigned char junk = 0;

    if (PIR1bits.SSP1IF) // check to see if SSP interrupt
    {
        INTCONbits.IOCIE = 0; //disable on change interrupts
        PIE1bits.TMR1IE = 0; //disable timer1 interrupt
        if (SSP1STATbits.R_nW) // Master read (R_nW = 1)
        {
            if (!SSP1STATbits.D_nA) // Last byte was an address (D_nA = 0)
            {
                SSP1BUF = I2C_buffer.byte[index_i2c++]; // load with value from array
                SSP1CON1bits.CKP = 1; // Release CLK
            }
            if (SSP1STATbits.D_nA) // Last byte was data (D_nA = 1)
            {
                SSP1BUF = I2C_buffer.byte[index_i2c++]; // load with value from array
                SSP1CON1bits.CKP = 1; // Release CLK
            }
        }
        if (!SSP1STATbits.R_nW) //  Master write (R_nW = 0)
        {
            if (!SSP1STATbits.D_nA) // Last byte was an address (D_nA = 0)
            {
                first_i2c = 1; //last byte was address, next will be data location
                junk = SSP1BUF; // read buffer to clear BF
                SSP1CON1bits.CKP = 1; // Release CLK
            }
            if (SSP1STATbits.D_nA) // Last byte was data (D_nA = 1)
            {
                if (first_i2c) {
                    index_i2c = SSP1BUF; // load index with array location
                    first_i2c = 0; // now clear this since we have 
                }//location to read from/write to

                else {
                    if (index_i2c < RX_ELMNTS) // make sure index is not
                    { //out of range of array
                        I2C_buffer.byte[index_i2c++] = SSP1BUF; //load array with data
                    } else {
                        junk = SSP1BUF; //array location not valid, discard data
                    }
                }
                if (SSP1CON1bits.WCOL) // Did a write collision occur?
                {
                    SSP1CON1bits.WCOL = 0; //  clear WCOL
                    junk = SSP1BUF; // dummy read to clear BF bit
                }
                SSP1CON1bits.CKP = 1; // Release CLK
            }
        }
        PIR1bits.SSP1IF = 0; // clear SSPIF flag bit
        INTCONbits.IOCIE = 1; //enable on change interrupts
        PIE1bits.TMR1IE = 1; //enable timer1 interrupt
    }

    if (PIR2bits.BCL1IF) // Did a bus collision occur?
    {
        junk = SSP1BUF; // dummy read SSPBUF to clear BF bit
        PIR2bits.BCL1IF = 0; // clear bus collision Int Flag bit
        SSP1CON1bits.CKP = 1; // Release CLK
        PIR1bits.SSP1IF = 0; // clear SSPIF flag bit
    }
}

// Functions

void PWM_Init(void) // start the PWM with a 0% duty
{
    /*
    //10 bit mode PWM at 1.95kHz
    PR2 = 0xFF; //load PR2 register
    CCP1CON = 0b00001100; //configure CCP1 for PWM operation
    CCPR1L = 0b00000000; //set duty to 0    
    PIR1bits.TMR2IF = 0; //clear the interrupt flag
    T2CON = 0b00000110; //start timer 2 and select prescaler as 4
     */

    /*    
    //10 bit mode PWM at 7.81kHz
    PR2 = 0xFF; //load PR2 register
    CCP1CON = 0b00001100; //configure CCP1 for PWM operation
    CCPR1L = 0b00000000; //set duty to 0    
    PIR1bits.TMR2IF = 0; //clear the interrupt flag
    T2CON = 0b00000101; //start timer 2 and select prescaler as 4
     */

    //10 bit mode PWM at 31.25kHz
    PR2 = 0xFF; //load PR2 register
    CCP1CON = 0b00001100; //configure CCP1 for PWM operation
    CCPR1L = 0b00000000; //set duty to 0    
    PIR1bits.TMR2IF = 0; //clear the interrupt flag
    T2CON = 0b00000100; //start timer 2 and select prescaler as 1

    /*
    //8 bit mode PWM at 125kHz
    PR2 = 0x3F; //load PR2 register
    CCP1CON = 0b00001100; //configure CCP1 for PWM operation
    CCPR1L = 0b00000000; //set duty to 0    
    PIR1bits.TMR2IF = 0; //clear the interrupt flag
    T2CON = 0b00000100; //start timer 2 and select prescaler as 1
     * */
}

void PWM_set_duty(unsigned int duty) // change the duty of PWM
{
    if (duty < 1024) {
        CCPR1L = (0xFF & ((unsigned int) duty >> 2)); //discard 2 LSB and write the rest to register, 10 bit mode
        CCP1CON = (0x0C | (0x30 & ((unsigned int) duty << 4))); //filter the reamaining 2 LSB and then write it to DC1B (bit 5,4 in the register), 10 bit mode
        //CCPR1L = (0xFF & ((unsigned int)duty)); //to be used in 8 bit mode
    }
}

void init_I2C_buffer() //load default values of vars
{
    I2C_buffer.data.ID = DEVICE_ID;
    I2C_buffer.data.TIMEOUT = timeout;
    I2C_buffer.data.BEEP = 250; //startup beep signal
    I2C_buffer.data.REMAIN = 0;
    I2C_buffer.data.DETECTED = 0;
    I2C_buffer.data.BRIGHTNESS = 0;
    I2C_buffer.data.RESET = 0;
}

int main(int argc, char** argv) {
    OSCCON = 0b11110000; //configure internal oscilator for 32Mhz
    init_I2C_buffer();
    TRISA = 0b00011110; //configure IO
    ANSELA = 0b00000000; //analog functions of pins disabled
    WPUA = 0b00011110; //configure weak pull-ups on input pins
    OPTION_REGbits.nWPUEN = 0; //enable/disable weak pull-ups
    APFCONbits.CCP1SEL = 1; //select RA5 as CCP output pin
    LATAbits.LATA0 = 0; //keep buzzer off
    SSP1STAT = 0b10000000; // Slew rate control disabled for standardspeed mode (100 kHz and 1 MHz)
    SSP1CON1 = 0b00110110; // Enable serial port, I2C slave mode, 7-bit address
    SSP1CON2bits.SEN = 1; // Clock stretching is enabled
    SSP1CON3bits.BOEN = 1; // SSPBUF is updated and NACK is generated for a received address/data byte, ignoring the state of the SSPOV bit only if the BF bit = 0
    SSP1CON3bits.SDAHT = 1; // Minimum of 300 ns hold time on SDA after the falling edge of SCL
    SSP1CON3bits.SBCDE = 1; // Enable slave bus collision detect interrupts
    SSP1ADD = (char) (I2C_slave_address << 1); // Load the slave address
    PIR1bits.SSP1IF = 0; // Clear the serial port interrupt flag
    PIR2bits.BCL1IF = 0; // Clear the bus collision interrupt flag
    PIE2bits.BCL1IE = 1; // Enable bus collision interrupts
    PIE1bits.SSP1IE = 1; // Enable serial port interrupts
    INTCONbits.PEIE = 1; // Enable peripheral interrupts
    PWM_Init(); //start pwm
    PWM_set_duty(0); //put duty of pwm to 0
    IOCAPbits.IOCAP4 = 1; //configure interrupt on rising edge for motion sensor
    INTCON = 0b01001000; //enables interrupts
    T1CON = 0b00110100; //configure timer1 to run at 1 MHz
    PIE1bits.TMR1IE = 1; //enable timer1 interrupt
    T1CONbits.TMR1ON = 1; //start timer1
    INTCONbits.GIE = 1; //run interrupts

    while (1) {
        asm("CLRWDT");
        if (I2C_buffer.data.RESET == 1) {
            asm("RESET");
        }
        PWM_set_duty(I2C_buffer.data.BRIGHTNESS); //set LCD backlight brightness
        if (I2C_buffer.data.BEEP > 0) //sound buzzer by requested ms time
        {
            LATAbits.LATA0 = 1;
            I2C_buffer.data.BEEP--;
        } else {
            LATAbits.LATA0 = 0;
        }
        if (I2C_buffer.data.DETECTED == 1) //clear proximity detection when timeout is over
        {
            I2C_buffer.data.REMAIN--;
            if (I2C_buffer.data.REMAIN == 0) {
                I2C_buffer.data.DETECTED = 0;
            }
        }
        __delay_ms(1);
    }

    return (EXIT_SUCCESS);
}
