2BRobots/skykontrolVending/(commit log)

2019-12-06 pcb design files
    [SkyKontrol-2BR.brd, SkyKontrol-2BR.sch, SkyKontrol-Display.brd, SkyKontrol-Display.sch]
2019-12-24 new modules
    [SkyKontrol-smartDisplay.brd, SkyKontrol-smartDisplay.sch]
2019-12-30 documentation add
    [SkyKontrol-IotController.brd, SkyKontrol-IotController.sch, SkyKontrol-powerMeter.brd, SkyKontrol-powerMeter.sch, SkyKontrol-slotExpansion.brd, SkyKontrol-slotExpansion.sch, SkyKontrol-smartDisplay.brd]
2020-02-13 BOM and corrections
    [SkyKontrol-powerMeter.brd, SkyKontrol-powerMeter.sch]
2020-02-21 slot expansion
2021-02-02 pcb corrected
    [usbTerminal.brd, usbTerminal.sch]
2021-02-03 Watchdog module add
    [SkyKontrol-watchdog.brd, SkyKontrol-watchdog.sch]
2021-02-21 LED polarity marks fix
    [usbTerminal.brd, usbTerminal.sch]
