2BRobots/skykontrolVending/(notices)

Notices in the files:
parts and their libraries:
SparkFun-Connectors: Licensing: Creative Commons ShareAlike 4.0 International - https://creativecommons.org/licenses/by-sa/4.0
con-sullins: Copyright (C) 2009, Bob Starr
